Sierra-Lobo/fp-pib-hw/revB/doc/pib-revB-bom.xlsx

Item | Qty | Reference(s) | Value | DNP | Description | Manufacturer | Mfr. Part No | LibPart | Footprint
1 | 3 | C1, C15, C16 | 0.01uF |  | CAP CER 10000PF 50V X7R 0603 | TDK Corporation | CGA3E2X7R1H103K080AE | Device:C | Capacitor_SMD:C_0603_1608Metric
2 | 10 | C2, C3, C5, C8, C9, C10, C11, C12, C13, C14 | 0.1uF |  | CAP CER 0.1UF 50V X7R 0402 | TDK Corporation | CGA2B3X7R1H104K050BE | Device:C | Capacitor_SMD:C_0603_1608Metric
3 | 2 | C4, C7 | 1uF |  | CAP CER 1UF 25V X7R 0603 | TDK Corporation | CGA3E1X7R1E105K080AE | Device:C | Capacitor_SMD:C_0603_1608Metric
4 | 1 | C6 | 10uF |  | CAP CER 10UF 25V X7S 0805 | TDK Corporation | CGA4J1X7S1E106K125AE | Device:C | Capacitor_SMD:C_0805_2012Metric
5 | 1 | D1 | RED |  | LED RED CLEAR SMD R/A | Kingbright | APA2107LSECK/J3-PRV | Device:D | SierraLobo:APA2107x
6 | 1 | D2 | YELLOW |  | LED YELLOW CLEAR SMD R/A | Kingbright | APA2107SYCK | Device:D | SierraLobo:APA2107x
7 | 1 | D3 | ORANGE |  | APA2107SECK | Kingbright | APA2107SECK | Device:D | SierraLobo:APA2107x
8 | 1 | D4 | GREEN |  | APA2107CGCK | Kingbright | APA2107CGCK | Device:D | SierraLobo:APA2107x
9 | 1 | J1 | T1M-10-F-SV-L |  | CONN HEADER SMD 10POS 1MM | Samtec | T1M-10-F-SV-L | Connector_Generic:Conn_01x10 | payload-interface-board:SAMTEC_T1M-10-F-SV-L
10 | 1 | J2 | T1M-10-F-SV-L |  | CONN HEADER SMD 10POS 1MM | Samtec | T1M-10-F-SV-L | Connector_Generic:Conn_02x05_Odd_Even | payload-interface-board:SAMTEC_T1M-10-F-SV-L
11 | 1 | Q1 | MMDT3946 |  | TRANS NPN/PNP 40V 0.2A SOT363 | Diodes Incorporated | MMDT3946-7-F | Transistor_BJT:MMDT3946 | Package_TO_SOT_SMD:SOT-363_SC-70-6
12 | 4 | Q2, Q3, Q10, Q11 | MMDT2222A |  | TRANS 2NPN 40V 0.6A SOT363 | Diodes Incorporated | MMDT2222A-7-F | SierraLobo:MMDT2222 | Package_TO_SOT_SMD:SOT-363_SC-70-6
13 | 4 | Q4, Q5, Q7, Q8 | BSZ180 |  | MOSFET P-CH 30V 9A/39.6A TSDSON | Infineon Technologies | BSZ180P03NS3GATMA1 | SierraLobo:BSZ086 | SierraLobo:PG-TSDSON-8_3.3x3.3mm
14 | 2 | Q6, Q9 | MMBT4401 |  | TRANS NPN 40V 0.6A SC70-3 | onsemi | MMBT4401WT1G | Device:Q_NPN_BEC | Package_TO_SOT_SMD:SOT-323_SC-70
15 | 2 | Q14, Q15 | BSS138 |  | MOSFET 2NCH 50V 200MA SOT363 | Diodes Incorporated | BSS138DWQ-7 | mainboard:BSS138DWQ-7 | Package_TO_SOT_SMD:SOT-363_SC-70-6
16 | 2 | R1, R5 | 100k | DNP | RES 100K OHM 1% 1/10W 0603 | Stackpole Electronics Inc | RMCF0603FT100K | Device:R_US | Resistor_SMD:R_0603_1608Metric
17 | 8 | R2, R6, R33, R36, R37, R40, R47, R48 | 100k |  | RES 100K OHM 1% 1/10W 0603 | Stackpole Electronics Inc | RMCF0603FT100K | Device:R_US | Resistor_SMD:R_0603_1608Metric
18 | 2 | R3, R4 | 4.7k |  | RES 4.7K OHM 1% 1/10W 0603 | Stackpole Electronics Inc | RMCF0603FT4K70 | Device:R_US | Resistor_SMD:R_0603_1608Metric
19 | 2 | R7, R9 | 0 |  | RES 0 OHM JUMPER 1/10W 0603 | Stackpole Electronics Inc | RMCF0603ZT0R00 | Device:R_US | Resistor_SMD:R_0603_1608Metric
20 | 4 | R8, R10, R51, R52 | 0 | DNP | RES 0 OHM JUMPER 1/10W 0603 | Stackpole Electronics Inc | RMCF0603ZT0R00 | Device:R_US | Resistor_SMD:R_0603_1608Metric
21 | 9 | R11, R12, R15, R16, R22, R41, R42, R43, R44 | 10k |  | RES 10K OHM 1% 1/10W 0603 | Stackpole Electronics Inc | RMCF0603FT10K0 | Device:R_US | Resistor_SMD:R_0603_1608Metric
22 | 8 | R13, R14, R17, R18, R34, R35, R38, R39 | 1k |  | RES 1K OHM 1% 1/10W 0603 | Stackpole Electronics Inc | RMCF0603FG1K00 | Device:R_US | Resistor_SMD:R_0603_1608Metric
23 | 2 | R19, R21 | 220 |  | RES 220 OHM 1% 1/10W 0603 | Stackpole Electronics Inc | RMCF0603FT220R | Device:R_US | Resistor_SMD:R_0603_1608Metric
24 | 1 | R20 | 976k |  | RES 976K OHM 1% 1/10W 0603 | Stackpole Electronics Inc | RMCF0603FT976K | Device:R_US | Resistor_SMD:R_0603_1608Metric
25 | 1 | R23 | 105k |  | RES 105K OHM 1% 1/10W 0603 | Stackpole Electronics Inc | RMCF0603FT105K | Device:R_US | Resistor_SMD:R_0603_1608Metric
26 | 1 | R24 | 576k |  | RES 576K OHM 1% 1/10W 0603 | Stackpole Electronics Inc | RMCF0603FT576K | Device:R_US | Resistor_SMD:R_0603_1608Metric
27 | 4 | R25, R26, R27, R28 | 1.5k |  | RES 1.5K OHM 1% 1/16W 0402 | Stackpole Electronics Inc | RMCF0402FT1K50 | Device:R_US | Resistor_SMD:R_0402_1005Metric
28 | 4 | R29, R30, R31, R32 | 10k |  | RES 10K OHM 1% 1/16W 0402 | Stackpole Electronics Inc | RMCF0402FT10K0 | Device:R_US | Resistor_SMD:R_0402_1005Metric
29 | 2 | R45, R46 | 680 |  | RES 680 OHM 1% 1/10W 0603 | Stackpole Electronics Inc | RMCF0603FT680R | Device:R_US | Resistor_SMD:R_0603_1608Metric
30 | 2 | R49, R50 | 200k |  | RES 200K OHM 1% 1/10W 0603 | Stackpole Electronics Inc | RMCF0603FT200K | Device:R_US | Resistor_SMD:R_0603_1608Metric
31 | 4 | RN1, RN3, RN4, RN6 | 1k |  | RES ARRAY 4 RES 10K OHM 0804 | Panasonic | EXB-28V102JX | FP-Interface-Card:R_Network04_US | Resistor_SMD:R_Array_Convex_4x0402
32 | 2 | RN2, RN5 | 10k |  | RES ARRAY 4 RES 1K OHM 0804 | Panasonic | EXB-28V103JX | SierraLobo:R_Network04_US | Resistor_SMD:R_Array_Convex_4x0402
33 | 17 | TP2, TP3, TP4, TP5, TP6, TP9, TP10, TP11, TP12, TP13, TP14, TP16, TP17, TP18, TP19, TP20, TP22 | ${NET_NAME(1)} |  | PC TEST POINT MINIATURE WHITE | Keystone | 5002 | Connector:TestPoint_Small | TestPoint:TestPoint_Keystone_5000-5004_Miniature
34 | 3 | TP7, TP15, TP21 | ${NET_NAME(1)} |  | PC TEST POINT MINIATURE | Keystone | 5027 | Connector:TestPoint_Small | SierraLobo:Keystone_5027
35 | 1 | U1 | LTC4307 |  | IC ACCELERATOR I2C HOTSWAP 8MSOP | Analog Devices | LTC4307IMS8#TRPBF | mainboard_SLI:LTC4307 | Package_SO:MSOP-8_3x3mm_P0.65mm
36 | 1 | U2 | RockBlock_9603 |  |  | Ground Control | FP-RB-9603 | SierraLobo:RockBlock_9603 | SierraLobo:RockBlock_9603
37 | 2 | U3, U4 | SN74LVCH245APWR |  | IC TXRX NON-INVERT 3.6V 20TSSOP | Texas Instruments | SN74LVCH245APWR | FP-Interface-Card:SN74LVCH245APWR | Package_SO:TSSOP-20_4.4x6.5mm_P0.65mm
38 | 2 | U5, U7 | MCP9700AT-E/LT |  | SENSOR ANALOG -40C-125C SC70-5 | Microchip Technology | MCP9700AT-E/LT | Sensor_Temperature:MCP9700Ax-ELT | Package_TO_SOT_SMD:SOT-353_SC-70-5
39 | 1 | U6 | imu-stamp-revA |  | PCBA, IMU | Sierra Lobo | RD21-6005A | FP-Interface-Card:imu-stamp-revA | payload-interface-board:imu-stamp-revA-SMD
