Sierra-Lobo/fp-pib-hw/revA1/FP Interface Card.xlsx

Item | Qty | Reference(s) | Value | LibPart | Footprint | Datasheet
1 | 31 | C1, C2, C16, C17, C18, C29, C31, C32, C33, C38, C39, C40, C41, C43, C44, C49, C50, C53, C55, C56, C57, C60, C61, C62, C63, C64, C65, C66, C67, C68, C69 | 0.1uF | Device:C | Capacitor_SMD:C_0603_1608Metric | ~
2 | 3 | C3, C51, C58 | 4.7uF | Device:C | Capacitor_SMD:C_0805_2012Metric | ~
3 | 7 | C4, C5, C6, C7, C8, C11, C12 | 0.1uF | Device:C | Capacitor_SMD:C_0402_1005Metric | ~
4 | 1 | C9 | 1nF | Device:C | Capacitor_SMD:C_0402_1005Metric | ~
5 | 1 | C10 | 10uF | Device:C | Capacitor_SMD:C_0603_1608Metric | ~
6 | 1 | C13 | 47uF | Device:C | Capacitor_SMD:C_1206_3216Metric | GRT31CR61A476KE13L
7 | 4 | C14, C15, C45, C46 | 2.2uF | Device:C | Capacitor_SMD:C_0805_2012Metric | ~
8 | 6 | C19, C20, C47, C48, C70, C71 | 10nF | Device:C | Capacitor_SMD:C_0603_1608Metric | ~
9 | 2 | C21, C22 | 0.47uF | Device:C | Capacitor_SMD:C_0603_1608Metric | ~
10 | 8 | C23, C24, C27, C28, C52, C54, C59, C72 | 1uF | Device:C | Capacitor_SMD:C_0603_1608Metric | ~
11 | 5 | C25, C26, C30, C35, C36 | 10uF | Device:C | Capacitor_SMD:C_0805_2012Metric | ~
12 | 3 | C34, C37, C42 | 560pF | Device:C | Capacitor_SMD:C_0603_1608Metric | ~
13 | 1 | C73 | 0.01uF | Device:C | Capacitor_SMD:C_0603_1608Metric | ~
14 | 3 | D1, D6, D7 | TPSMF4L6.0A | Device:D_TVS | Diode_SMD:D_SOD-123F | TPSMF4L6.0A
15 | 1 | D2 | RED | Device:D | SLI-Backplane-Blank-Card-KiCad:APA2107x | APA2107LSECK/J3-PRV
16 | 1 | D3 | YELLOW | Device:D | SLI-Backplane-Blank-Card-KiCad:APA2107x | APA2107SYCK/J3-PRV
17 | 1 | D4 | GREEN | Device:D | SLI-Backplane-Blank-Card-KiCad:APA2107x | APA2107CGCK
18 | 1 | D5 | ORANGE | Device:D | SLI-Backplane-Blank-Card-KiCad:APA2107x | APA2107SECK/J4-PRV
19 | 1 | D8 | S1G | Device:D | Diode_SMD:D_SMA | S1G
20 | 4 | H1, H2, H3, H4 | SLI-Backplane-Blank-Card-KiCad:125mil_hole | Mechanical:MountingHole_Pad | SLI-Backplane-Blank-Card-KiCad:125mil_hole | ~
21 | 1 | J1 | T1M-10-F-SV-L | Connector_Generic:Conn_01x10 | payload-interface-board:SAMTEC_T1M-10-F-SV-L | T1M-10-F-SV-L
22 | 1 | J3 | ZX62-AB-5PA(31) | Connector:USB_B_Micro | SLI-Backplane-Blank-Card-KiCad:ZX62-AB-5PA(31) | ZX62-AB-5PA(31)
23 | 1 | J4 | T1M-6-F-SV-L | Connector_Generic:Conn_01x06 | payload-interface-board:SAMTEC_T1M-06-F-SV-L | T1M-6-F-SV-L
24 | 1 | J5 | T1M-10-F-SV-L | Connector_Generic:Conn_02x05_Odd_Even | payload-interface-board:SAMTEC_T1M-10-F-SV-L | T1M-10-F-SV-L
25 | 1 | P1 | Card Edge for HSEC8-160-01-S-DV-A-K-TR | SLI-Backplane-Blank-Card-KiCad:Conn_02x60_Top_Bottom | SLI-Backplane-Blank-Card-KiCad:HSEC8-160-CARD-EDGE
26 | 4 | Q1, Q2, Q3, Q4 | BC847BM3T5G | Device:Q_NPN_BEC | Package_TO_SOT_SMD:SOT-723 | BC847BM3T5G
27 | 4 | Q5, Q7, Q13, Q15 | BSS138DWQ-7 | mainboard:BSS138DWQ-7 | Package_TO_SOT_SMD:SOT-363_SC-70-6 | BSS138DWQ-7
28 | 4 | Q6, Q8, Q14, Q16 | MMDT5551-7-F | mainboard-rescue:MBT2222ADW1T1-Transistor_BJT-mainboard-rescue | Package_TO_SOT_SMD:SOT-363_SC-70-6 | MMDT5551-7-F
29 | 6 | Q9, Q10, Q11, Q12, Q24, Q26 | BSS138 | Device:Q_NMOS_GSD | Package_TO_SOT_SMD:SOT-23 | BSS138
30 | 4 | Q17, Q18, Q20, Q22 | MMBT4401-7-F | Device:Q_NPN_BEC | Package_TO_SOT_SMD:SOT-23 | MMBT4401-7-F
31 | 3 | Q19, Q21, Q23 | IRF7404TRPBF | SLI-Backplane-Blank-Card-KiCad:IRF7404TRPBF | Package_SO:SO-8_3.9x4.9mm_P1.27mm | IRF7404TRPBF
32 | 13 | R1, R2, R3, R30, R31, R41, R43, R59, R60, R61, R62, R63, R64 | 100 | Device:R_US | Resistor_SMD:R_0603_1608Metric | ~
33 | 8 | R4, R7, R8, R9, R11, R12, R14, R15 | 1.5k | Device:R_US | Resistor_SMD:R_0402_1005Metric | ~
34 | 1 | R5 | 1Meg | Device:R_US | Resistor_SMD:R_0402_1005Metric | ~
35 | 3 | R6, R10, R13 | 10k | Device:R_US | Resistor_SMD:R_0402_1005Metric | ~
36 | 24 | R16, R17, R18, R20, R22, R25, R35, R39, R40, R42, R44, R47, R52, R77, R82, R90, R93, R94, R99, R103, R104, R105, R111, R112 | 100k | Device:R_US | Resistor_SMD:R_0603_1608Metric | ~
37 | 28 | R19, R21, R23, R24, R49, R50, R54, R55, R65, R67, R68, R70, R71, R73, R74, R76, R79, R80, R84, R85, R89, R91, R100, R106, R108, R110, R114, R116 | 10k | Device:R_US | Resistor_SMD:R_0603_1608Metric | ~
38 | 6 | R26, R27, R28, R29, R45, R46 | 51 | Device:R_US | Resistor_SMD:R_0603_1608Metric | ~
39 | 2 | R32, R33 | 200mR | Device:R_US | Resistor_SMD:R_0805_2012Metric | RL1220S-R20-F
40 | 1 | R34 | 91mR | Device:R_US | Resistor_SMD:R_0805_2012Metric | UCR10EVHFSR091
41 | 3 | R36, R37, R38 | 33 | Device:R_US | Resistor_SMD:R_0603_1608Metric | ~
42 | 4 | R48, R53, R78, R83 | 680 | Device:R_US | Resistor_SMD:R_0603_1608Metric | ~
43 | 4 | R51, R56, R81, R86 | 200K | Device:R_US | Resistor_SMD:R_0603_1608Metric | ~
44 | 8 | R57, R58, R87, R88, R95, R96, R97, R98 | 0 | Device:R_US | Resistor_SMD:R_0603_1608Metric | ~
45 | 6 | R66, R69, R72, R75, R109, R115 | DNP | Device:R_US | Resistor_SMD:R_0603_1608Metric | ~
46 | 3 | R92, R101, R107 | 3.3k | Device:R_US | Resistor_SMD:R_0603_1608Metric | ~
47 | 1 | R102 | 100k | Device:R_US |  | ~
48 | 2 | R113, R117 | 4.7k | Device:R_US | Resistor_SMD:R_0603_1608Metric | ~
49 | 3 | RN1, RN2, RN3 | MAX5490GC01000+T | FP-Interface-Card:MAX5490GC01000+T | Package_TO_SOT_SMD:SOT-23 | MAX5490GC01000+T
50 | 1 | SW1 | SW_Push_SPST | Switch:SW_Push | SLI-Backplane-Blank-Card-KiCad:EVQP7C01P | EVQP7C01P
51 | 37 | TP1, TP2, TP3, TP4, TP5, TP6, TP7, TP8, TP9, TP10, TP11, TP12, TP13, TP14, TP15, TP16, TP17, TP18, TP19, TP20, TP21, TP22, TP23, TP24, TP25, TP26, TP27, TP28, TP29, TP30, TP31, TP32, TP33, TP34, TP35, TP38, TP39 | TestPoint | Connector:TestPoint | TestPoint:TestPoint_Pad_D1.0mm | ~
52 | 3 | U1, U16, U19 | DRV8838DSGT | magnetotorquer-test-board:DRV8838DSGT | Package_SON:WSON-8-1EP_2x2mm_P0.5mm_EP0.9x1.6mm | DRV8838DSGT
53 | 1 | U2 | AP2161W | Power_Management:AP2161W | Package_TO_SOT_SMD:SOT-23-5 | AP2161W
54 | 2 | U3, U4 | IAM-20380 | mainboard_SLI:IAM-20380 | payload-interface-board:IAM-20380 | IAM-20380
55 | 1 | U5 | PCA9543APW,118 | mainboard_SLI:PCA9543APW,118 | Package_SO:TSSOP-14_4.4x5mm_P0.65mm | PCA9543APW,118
56 | 2 | U6, U7 | MMC5983MA | mainboard_SLI:MMC5983MA | payload-interface-board:MMC5983MA | MMC5983MA
57 | 2 | U8, U9 | MXC6655XA | mainboard_SLI:MXC6655XA | payload-interface-board:MXC6655XA | MXC6655XA
58 | 1 | U10 | MAX7311AAG+ | FP-Interface-Card:MAX7311AAG+ | Package_SO:SSOP-24_5.3x8.2mm_P0.65mm | MAX7311AAG+
59 | 1 | U11 | MCP47FVB24-E/MQ | FP-Interface-Card:MCP47FVB24-E{slash}MQ | payload-interface-board:MCP47FVB24EMQ | MCP47FVB24-E/MQ
60 | 2 | U12, U15 | ALM2402QPWPRQ1 | magnetotorquer-test-board:ALM2402QPWPRQ1 | Package_SO:HTSSOP-14-1EP_4.4x5mm_P0.65mm_EP3.4x5mm_Mask3x3.1mm | ALM2402QPWPRQ1
61 | 4 | U13, U21, U22, U23 | OPA340MDBVTEP | Amplifier_Operational:OPA340NA | Package_TO_SOT_SMD:SOT-23-5 | OPA340MDBVTEP
62 | 1 | U14 | AD7091R-5BCPZ-RL7 | FP-Interface-Card:AD7091R-5BCPZ-RL7 | Package_DFN_QFN:QFN-20-1EP_4x4mm_P0.5mm_EP2.5x2.5mm | AD7091R-5BCPZ-RL7
63 | 3 | U17, U18, U20 | INA240A3EDRQ1 | FP-Interface-Card:INA240AxxD | Package_SO:SOIC-8_3.9x4.9mm_P1.27mm | INA240A3EDRQ1
64 | 1 | U24 | RockBlock_9603 | FP-Interface-Card:RockBlock_9603 | payload-interface-board:RockBlock_9603 | RockBlock_9603
65 | 1 | U25 | Pico | RPi_Pico:Pico | RPi_Pico:RPi_Pico_SMD_TH | Pico
66 | 1 | U26 | LTC4307 | mainboard_SLI:LTC4307 | Package_SO:MSOP-8_3x3mm_P0.65mm | LTC4307
67 | 2 | Z1, Z2 | CG0402MLU-05G | Device:Varistor | Capacitor_SMD:C_0402_1005Metric | CG0402MLU-05G
