Sierra-Lobo/fp-pib-hw/FP Interface Card.step

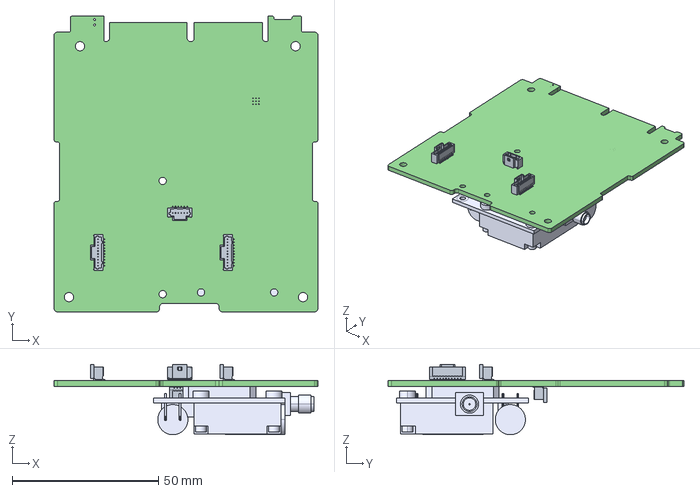
[picture p1: CAD file, 2022-05-12]
FP Interface Card.step
90.2 x 101.1 x 24.1 mm
FP Interface Card PCB
