Sierra-Lobo/fp-pib-hw/revB/doc/pib-revB-sch.pdf

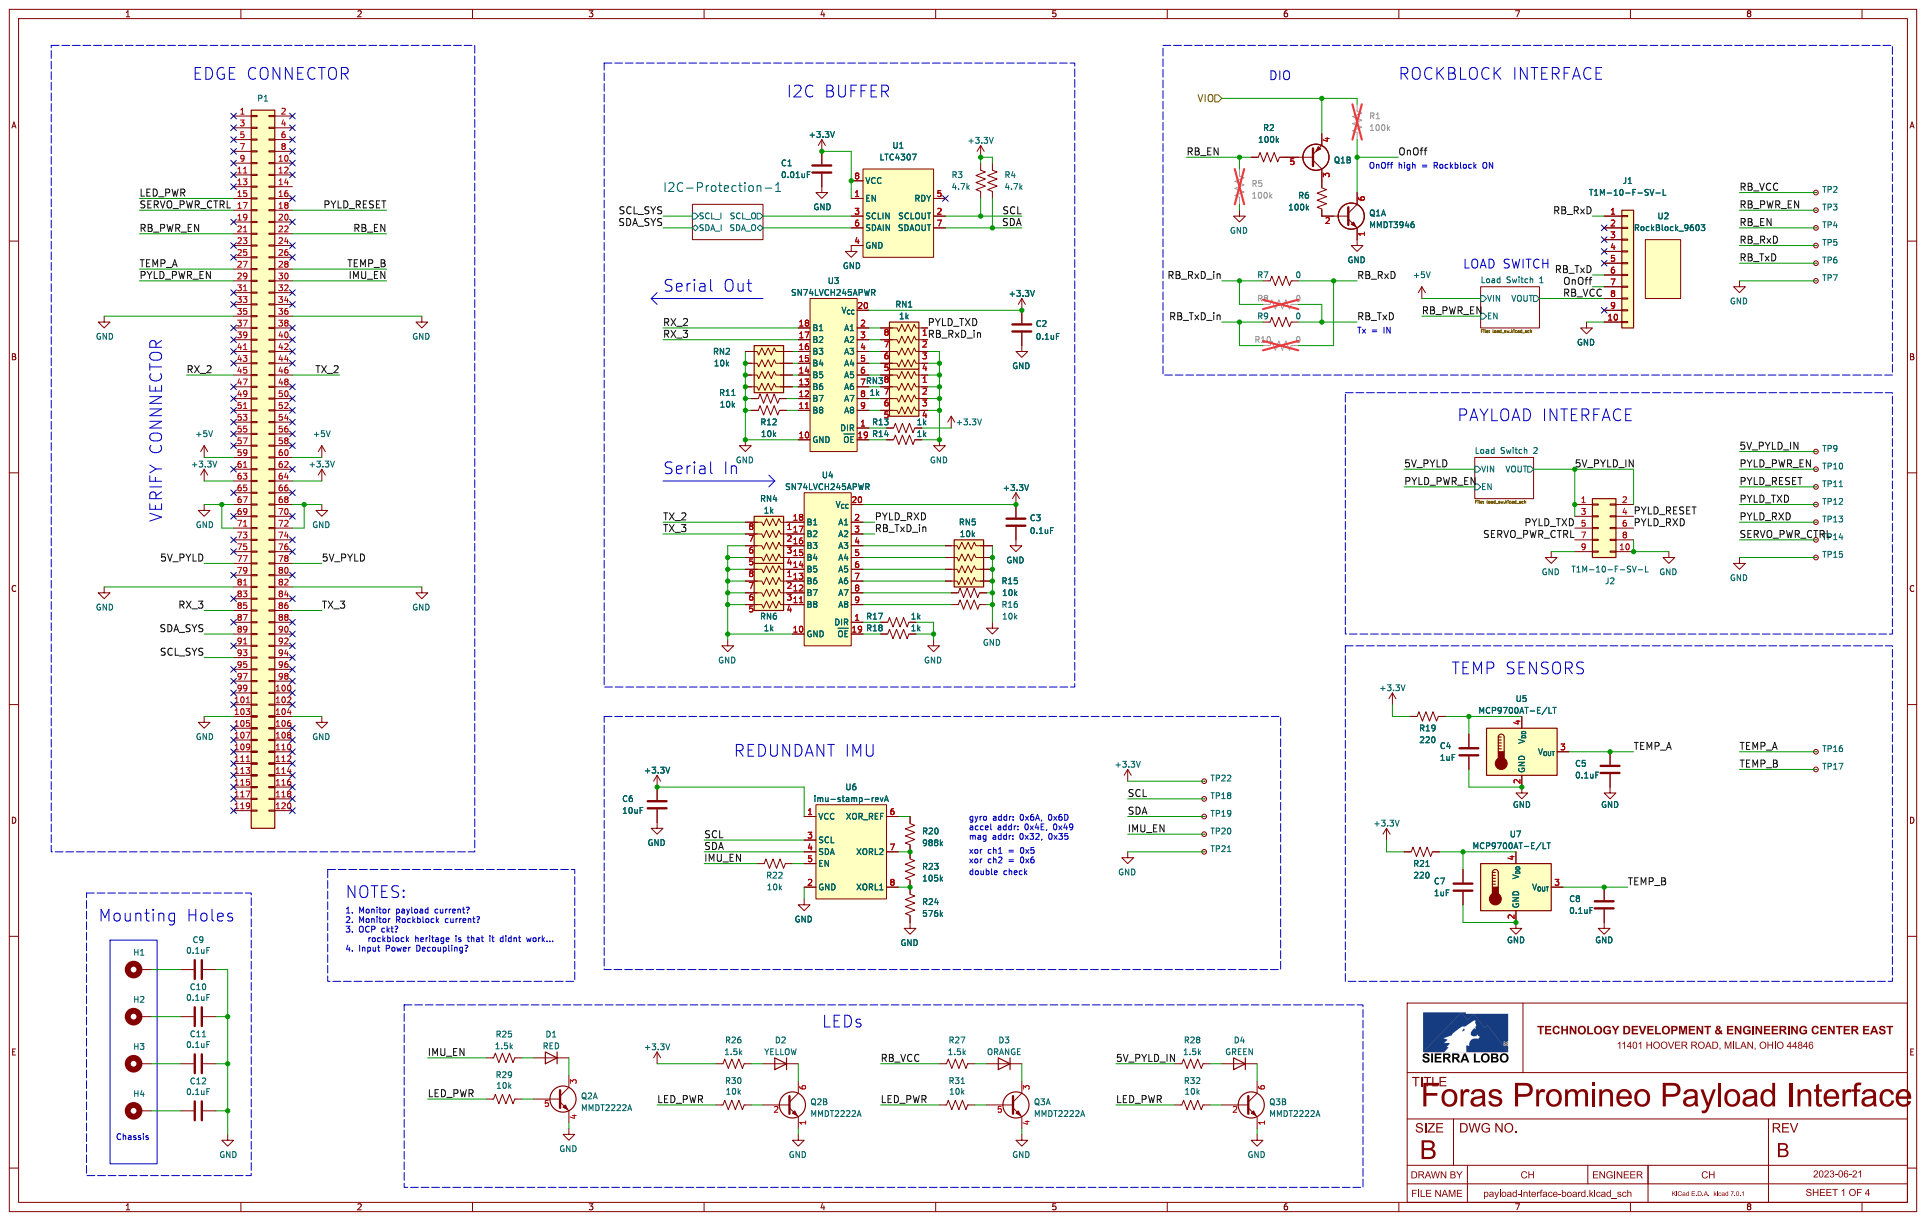
[picture p2: page 1]

Tx = IN ROCKBLOCK INTERFACE

TECHNOLOGY DEVELOPMENT & ENGINEERING CENTER EAST

11401 HOOVER ROAD, MILAN, OHIO 44846 TITLE
SHEET 1 OF 4 Foras Promineo Payload Interface

payload-interface-board.kicad_sch

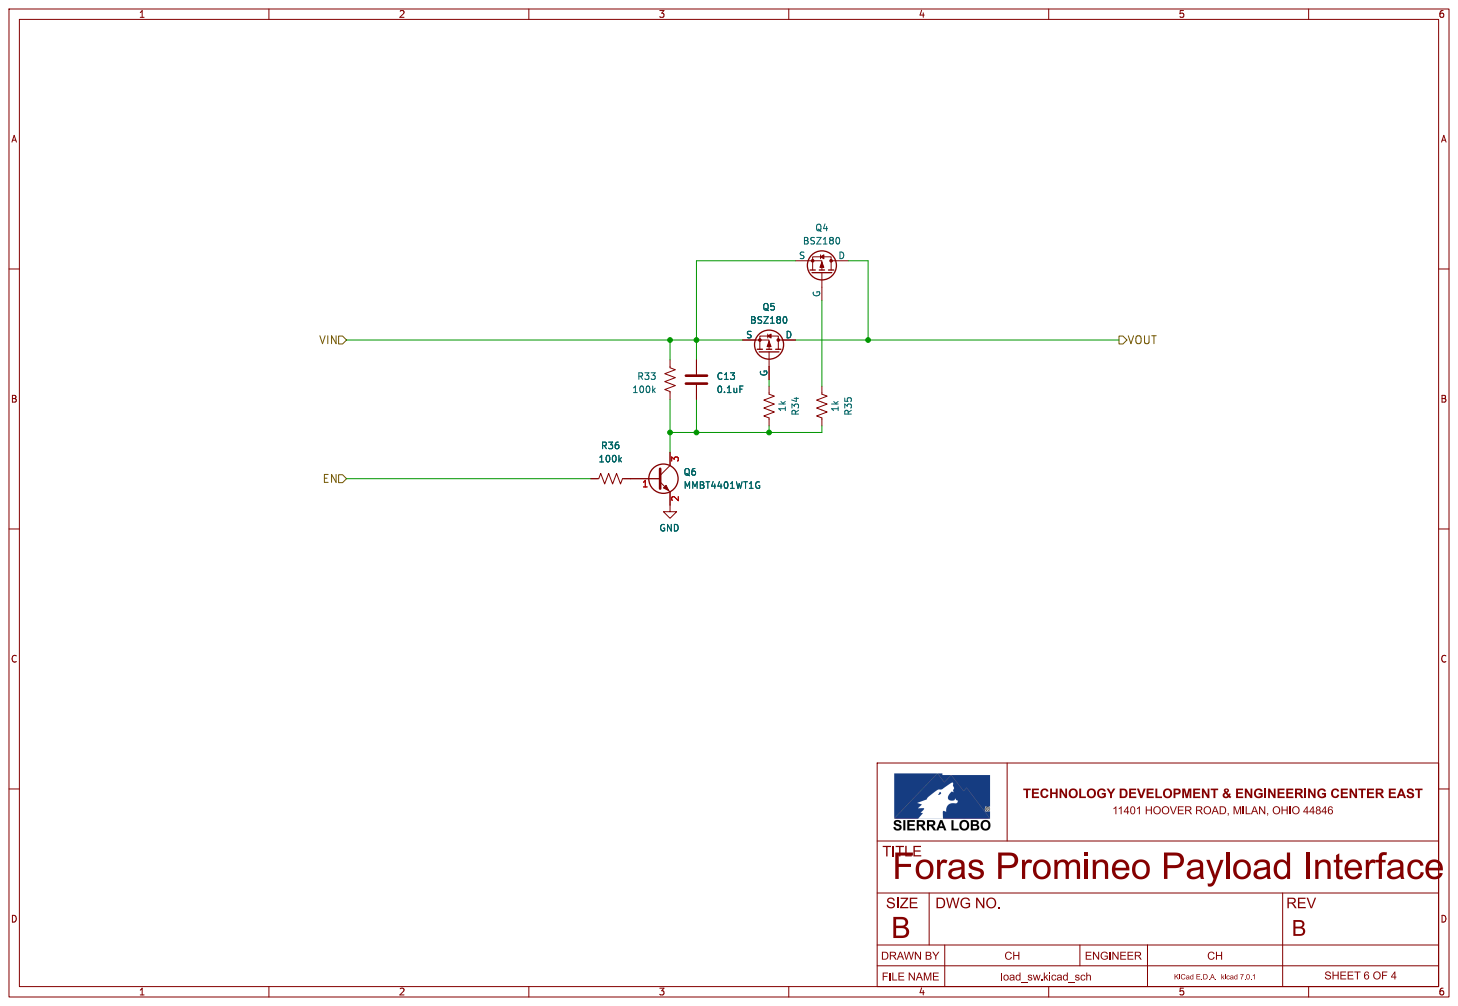
[picture p3: page 2]

TECHNOLOGY DEVELOPMENT & ENGINEERING CENTER EAST

11401 HOOVER ROAD, MILAN, OHIO 44846 TITLE
SHEET 6 OF 4 Foras Promineo Payload Interface

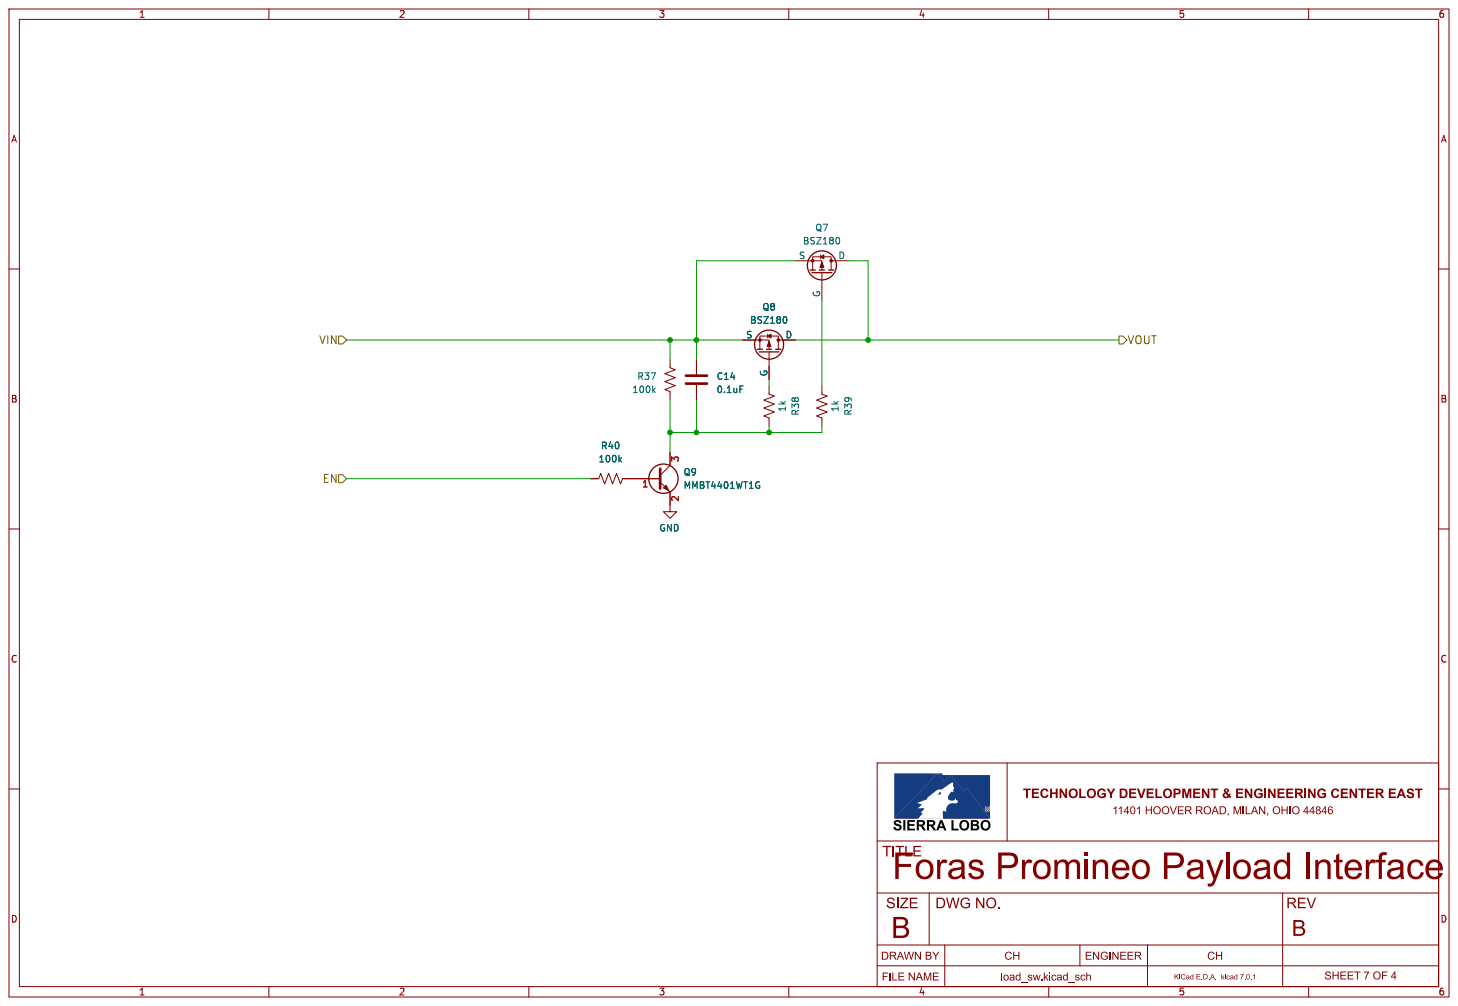
[picture p4: page 3]

TECHNOLOGY DEVELOPMENT & ENGINEERING CENTER EAST

11401 HOOVER ROAD, MILAN, OHIO 44846 TITLE
SHEET 7 OF 4 Foras Promineo Payload Interface

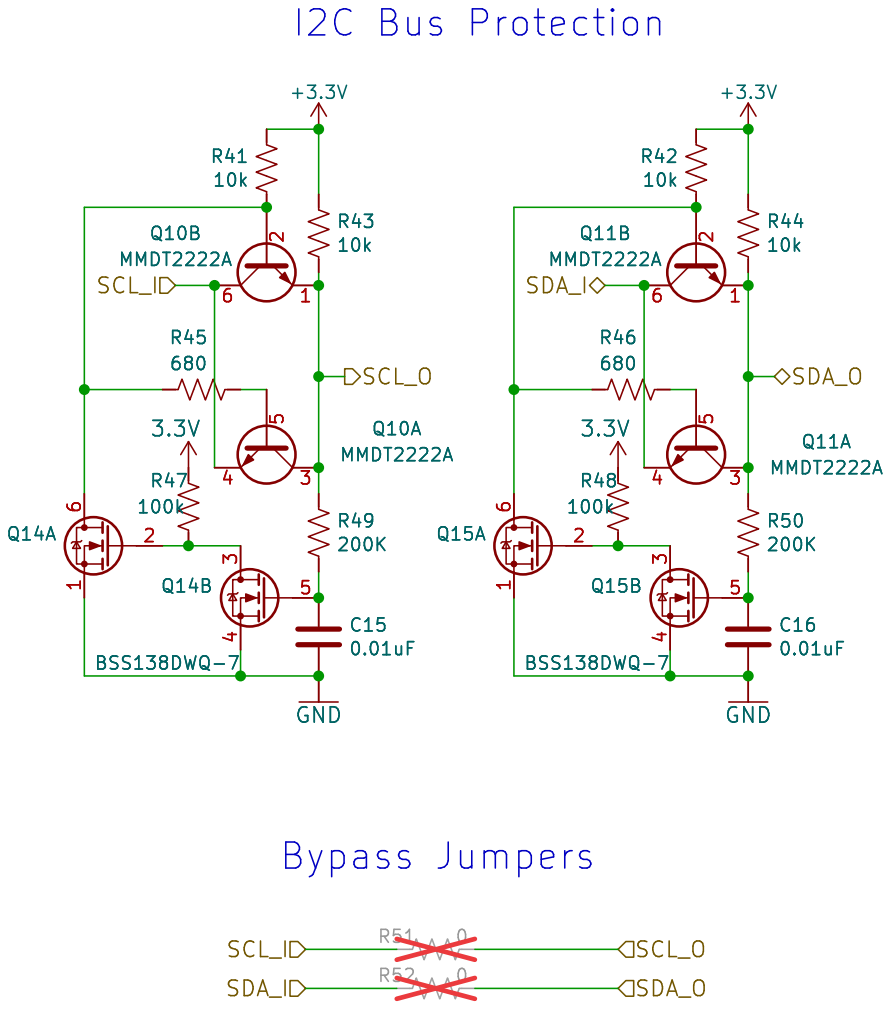
[picture p5: page 4]

TECHNOLOGY DEVELOPMENT & ENGINEERING CENTER EAST

11401 HOOVER ROAD, MILAN, OHIO 44846 TITLE
SHEET 11 OF 4 Foras Promineo Payload Interface
