Sierra-Lobo/fp-pib-hw/revA1/pdf/FP Interface Card.pdf

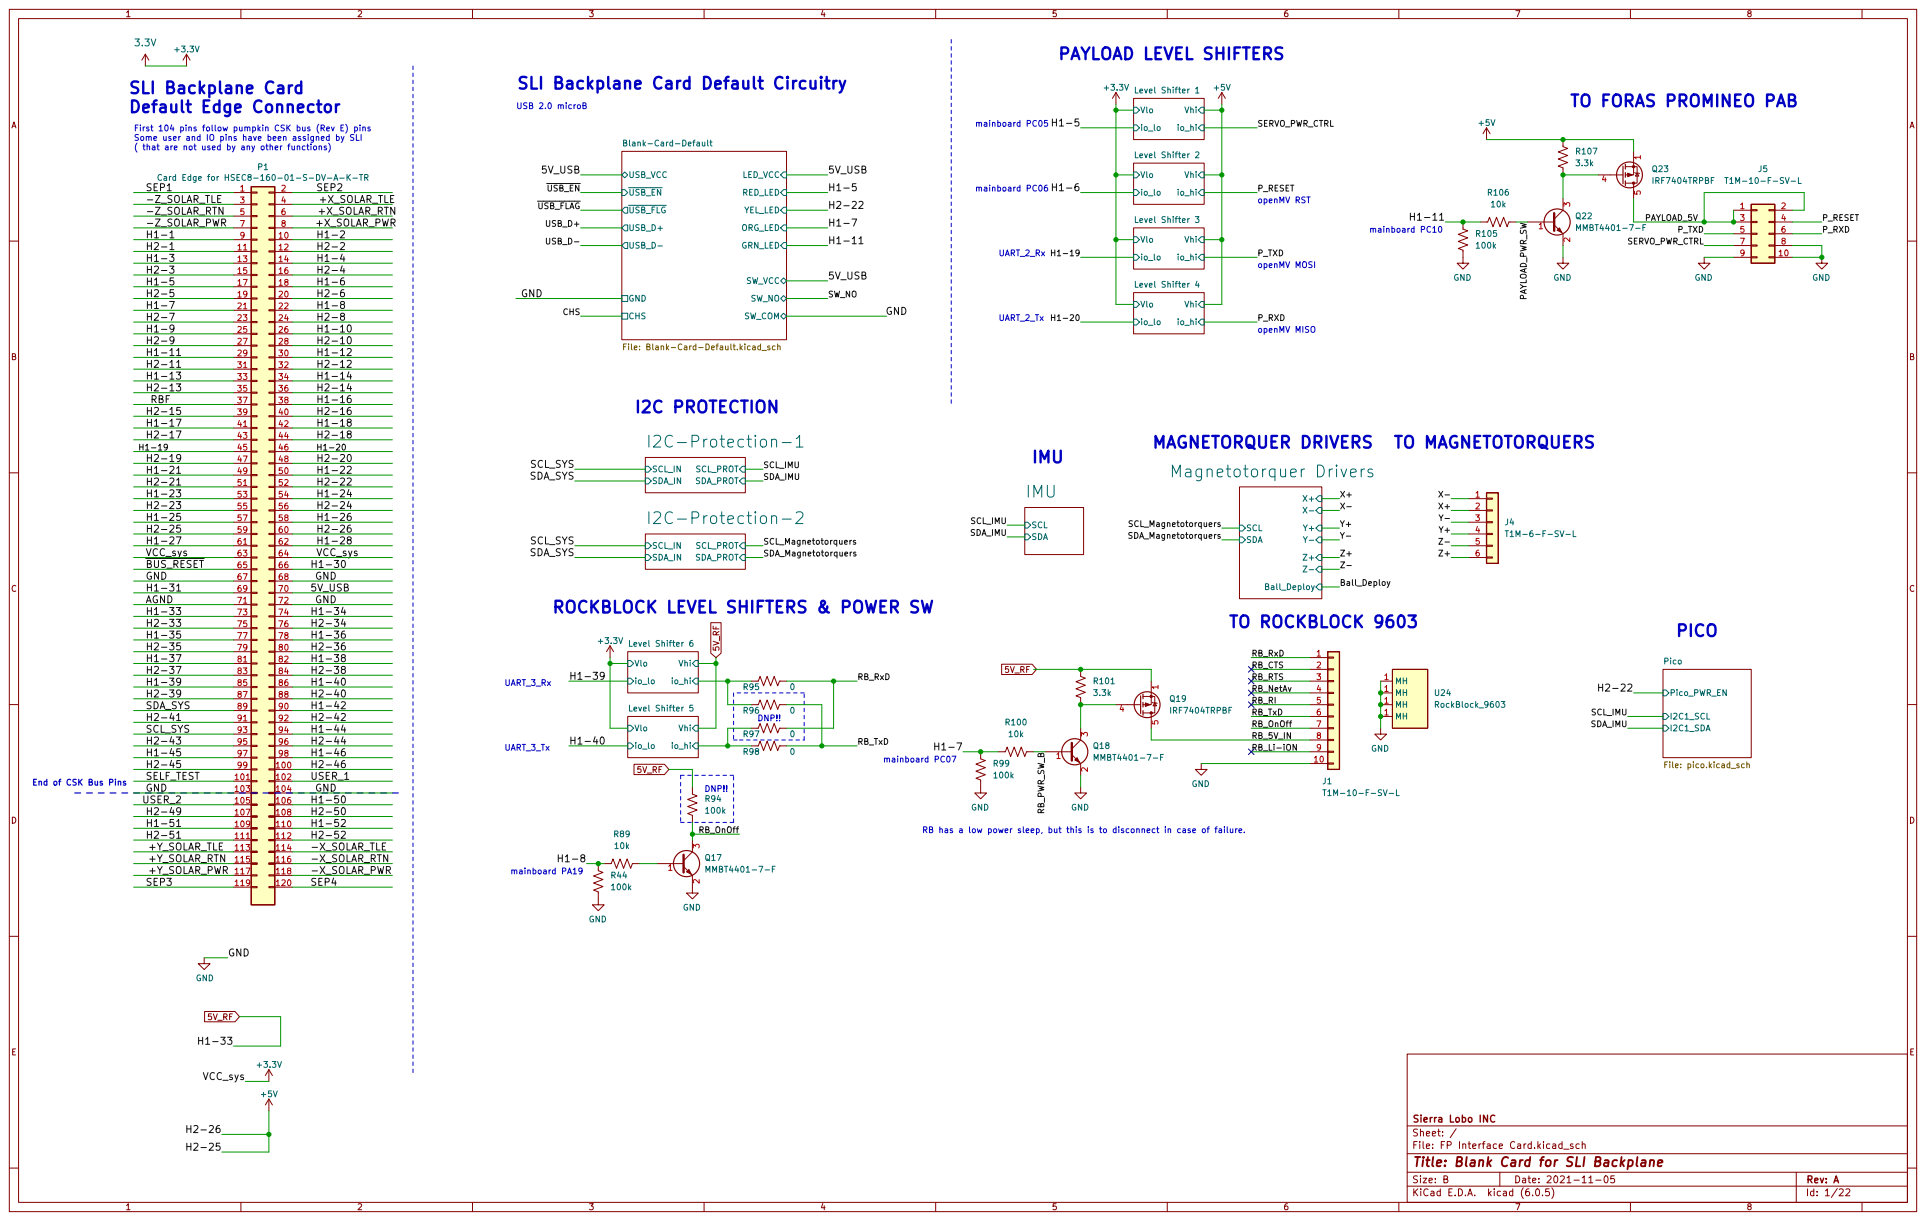
[picture p6: page 1]

Blank-Card-Default File: Blank-Card-Default.kicad_sch SDA_PROT SCL_IN

openMV RST mainboard PC05 mainboard PC06 SLI Backplane Card
Default Edge Connector

UART_2_Tx First 104 pins follow pumpkin CSK bus (Rev E) pins
Some user and IO pins have been assigned by SLI
( that are not used by any other functions)
SEP1 H2-3
-Z_SOLAR_TLE
-Z_SOLAR_RTN
-Z_SOLAR_PWR

P1 Card Edge for HSEC8-160-01-S-DV-A-K-TR

4 +X_SOLAR_TLE
+X_SOLAR_RTN 6

Pico File: pico.kicad_sch SCL SDA

ROCKBLOCK LEVEL SHIFTERS & POWER SW

-X_SOLAR_TLE
-X_SOLAR_RTN

File: FP Interface Card.kicad_sch Sheet: / Sierra Lobo INC

Id: 1/22 Title: Blank Card for SLI Backplane

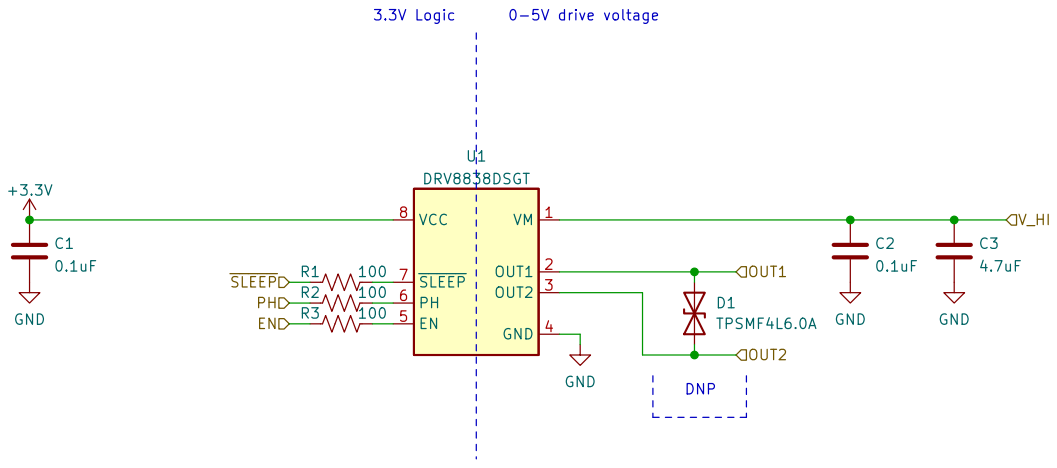
[picture p7: page 2]

Sheet: /Magnetotorquer Drivers/Full Bridge 2/
File: Full_Bridge.kicad_sch
Id: 2/22 Title:

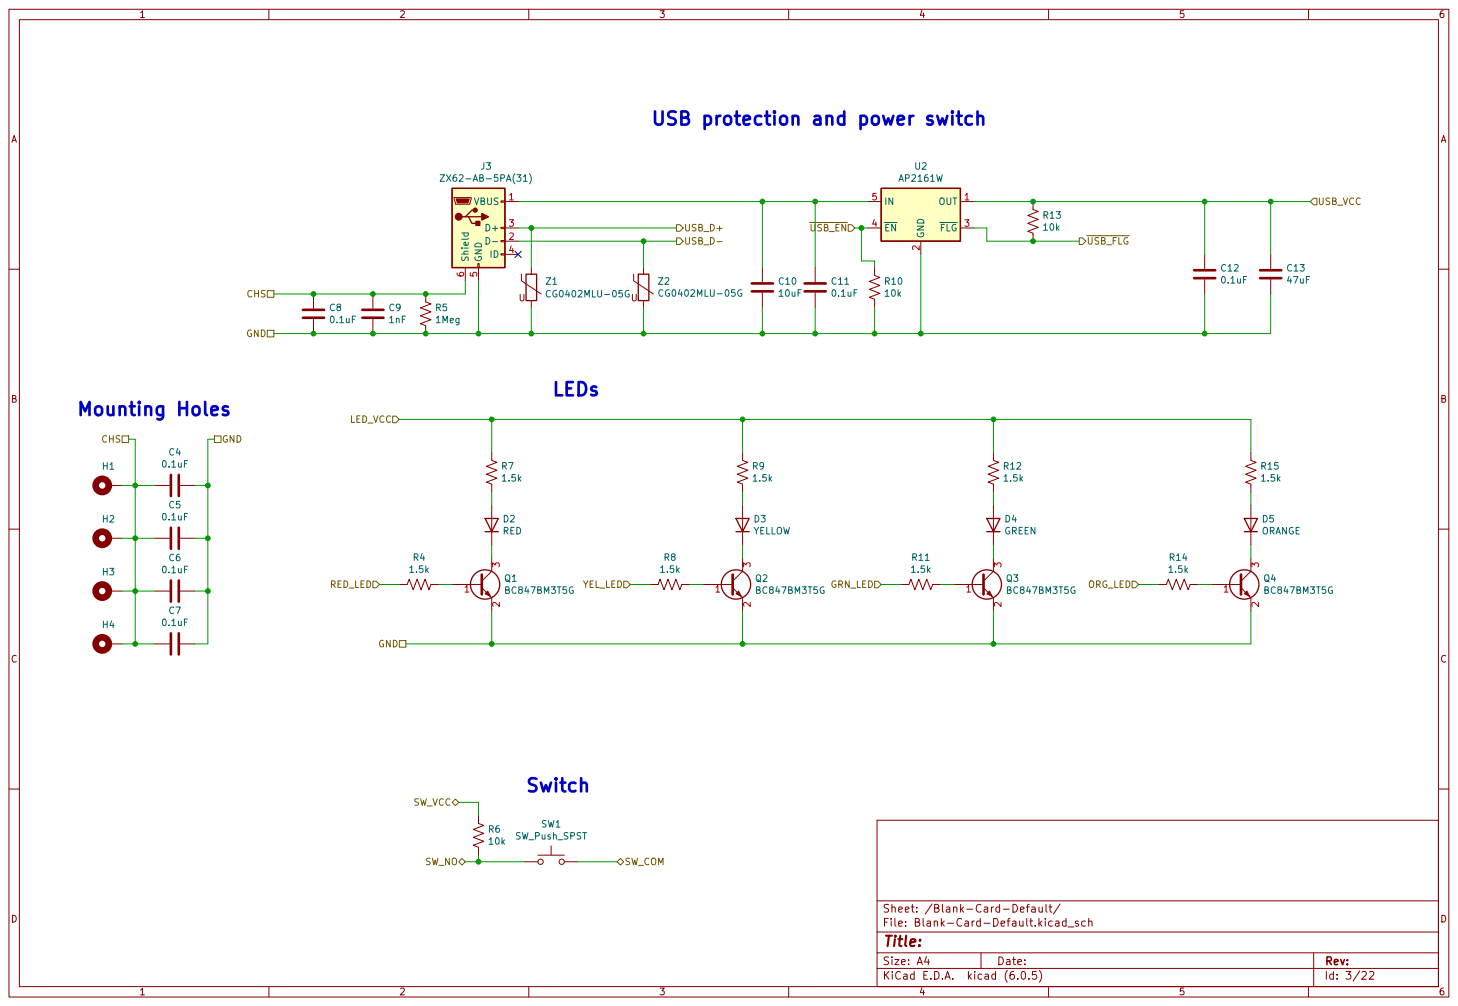
[picture p8: page 3]

CHS do we even need power thru usb?
USB_D+ SW_NO

USB protection and power switch
~{USB_EN} GRN_LED

File: Blank-Card-Default.kicad_sch Sheet: /Blank-Card-Default/ 1

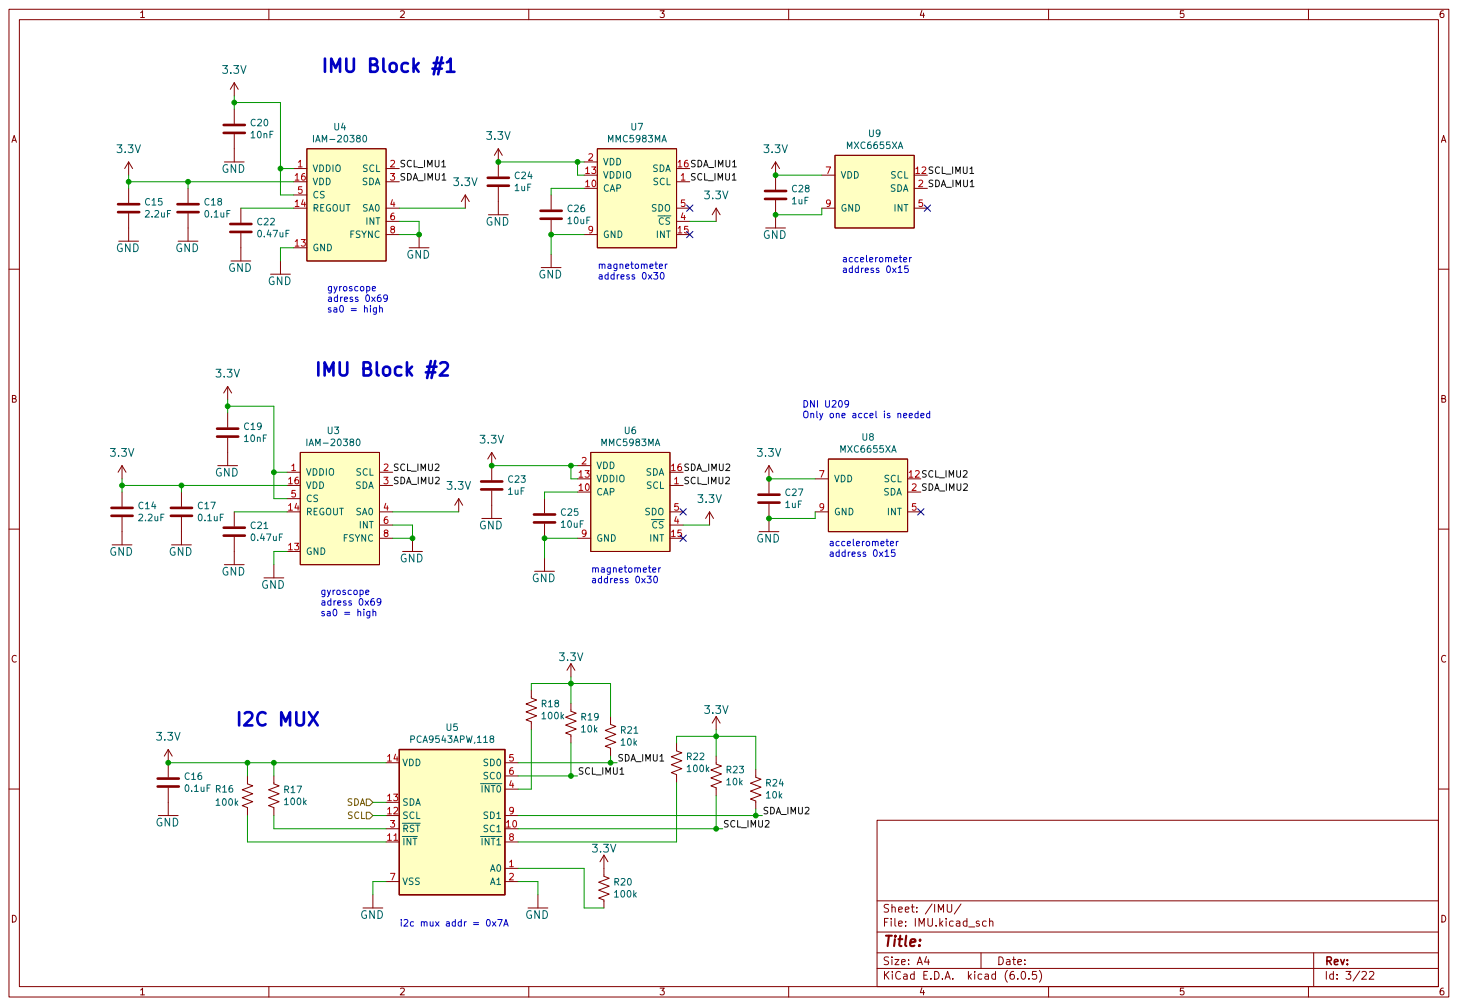
[picture p9: page 4]

File: IMU.kicad_sch Sheet: /IMU/

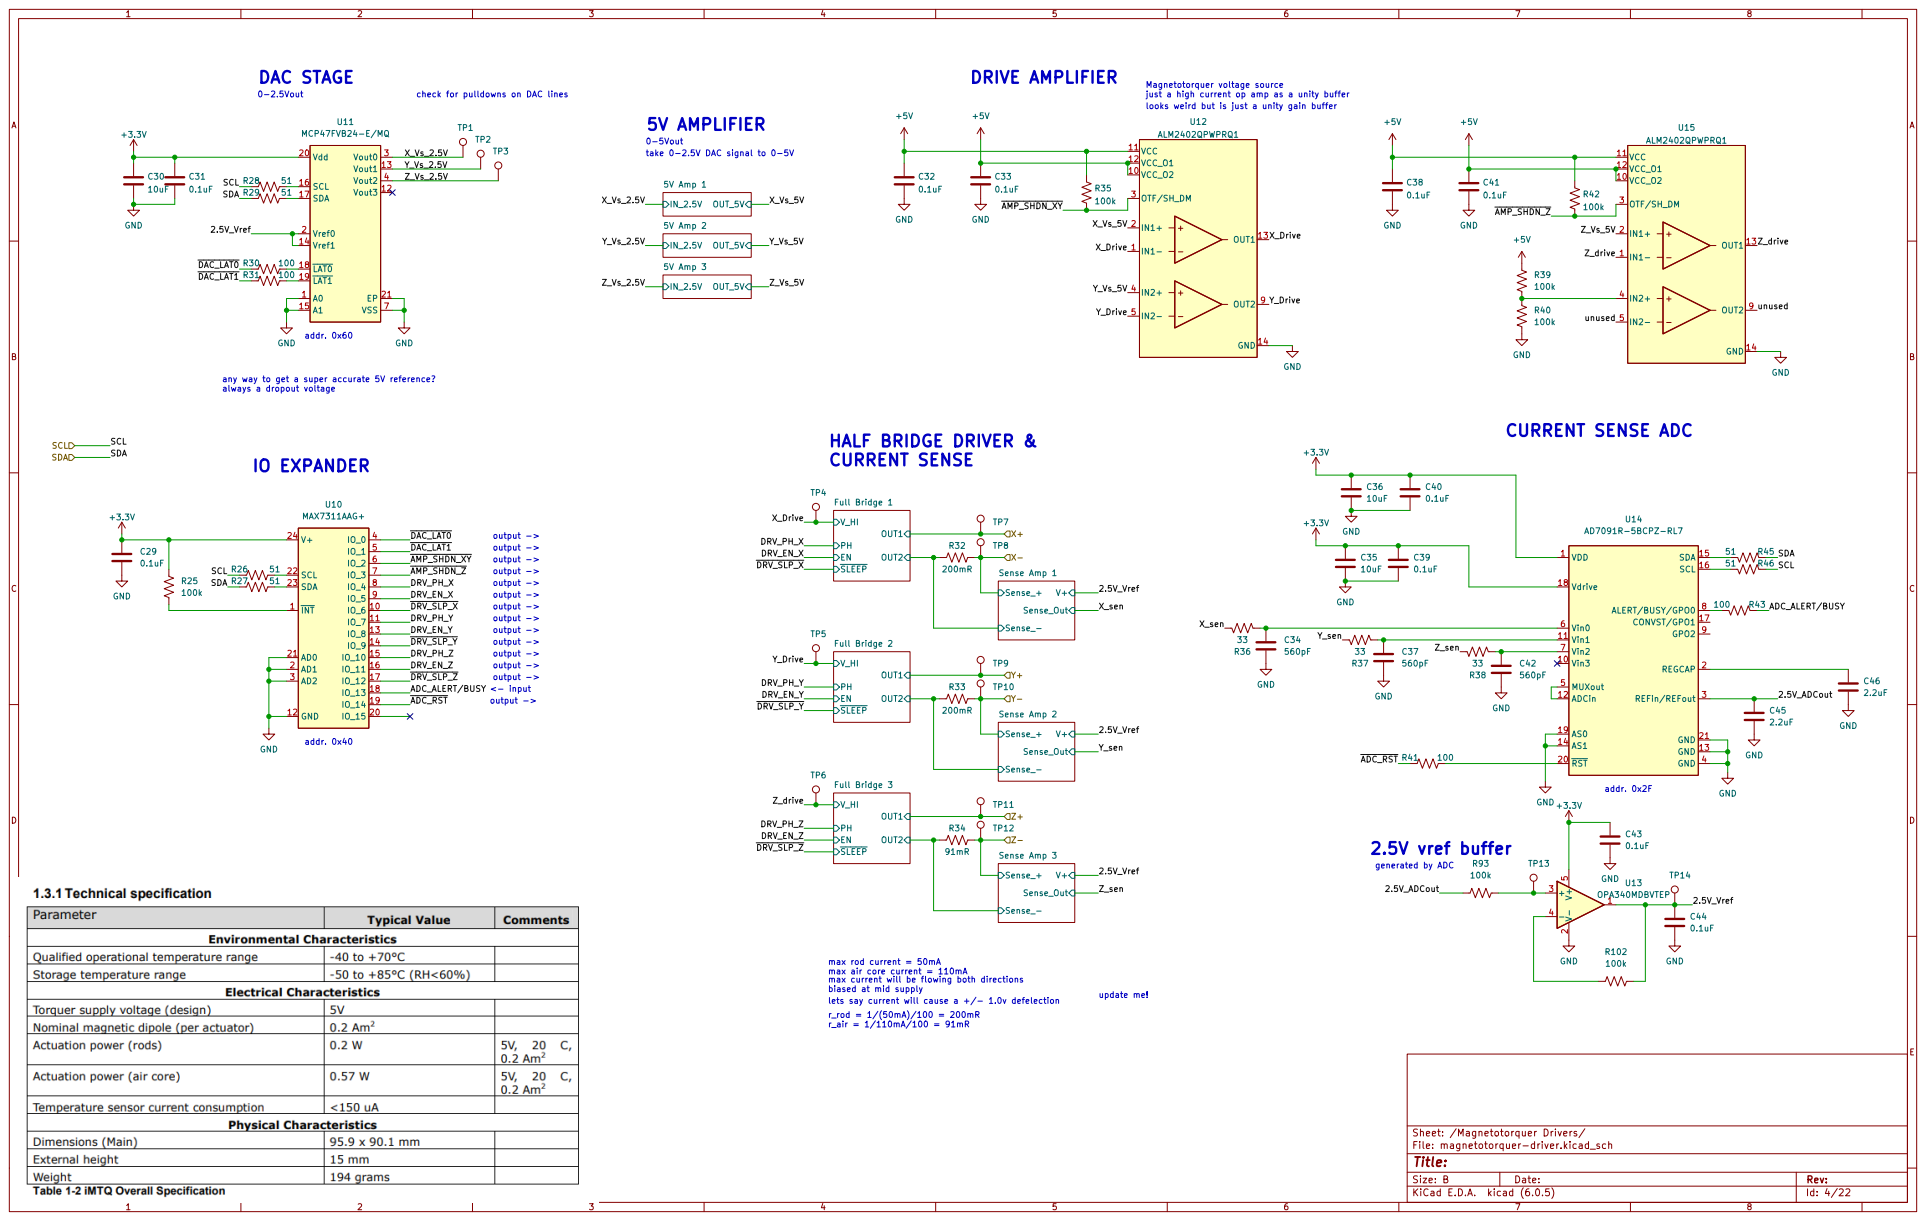
[picture p10: page 5]

Magnetotorquer voltage source
just a high current op amp as a unity buffer
looks weird but is just a unity gain buffer
0.1uF GND

check for pulldowns on DAC lines

take 0-2.5V DAC signal to 0-5V

any way to get a super accurate 5V reference?
always a dropout voltage

lets say current will cause a +/- 1.0v defelection max rod current = 50mA max air core current = 110mA max current will be flowing both directions

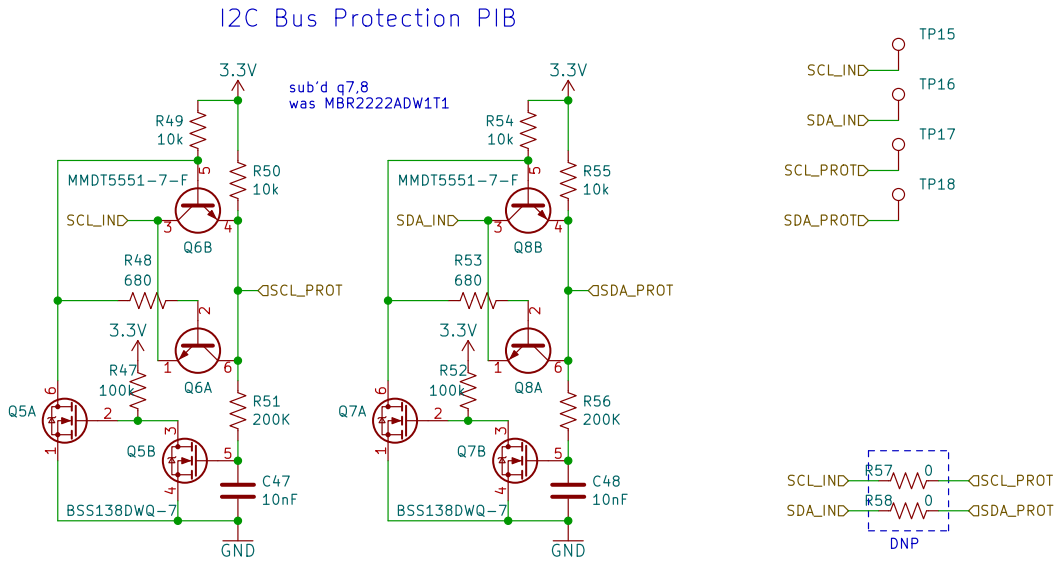
[picture p11: page 6]

File: I2C-Protection.kicad_sch Sheet: /I2C-Protection-2/
Id: 5/22 Title:

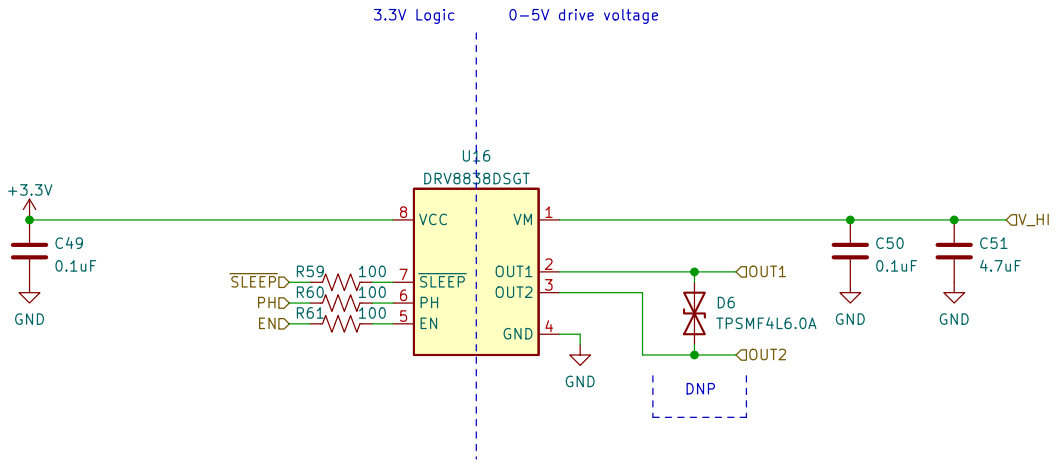
[picture p12: page 7]

Sheet: /Magnetotorquer Drivers/Full Bridge 1/
File: Full_Bridge.kicad_sch
Id: 6/22 Title:

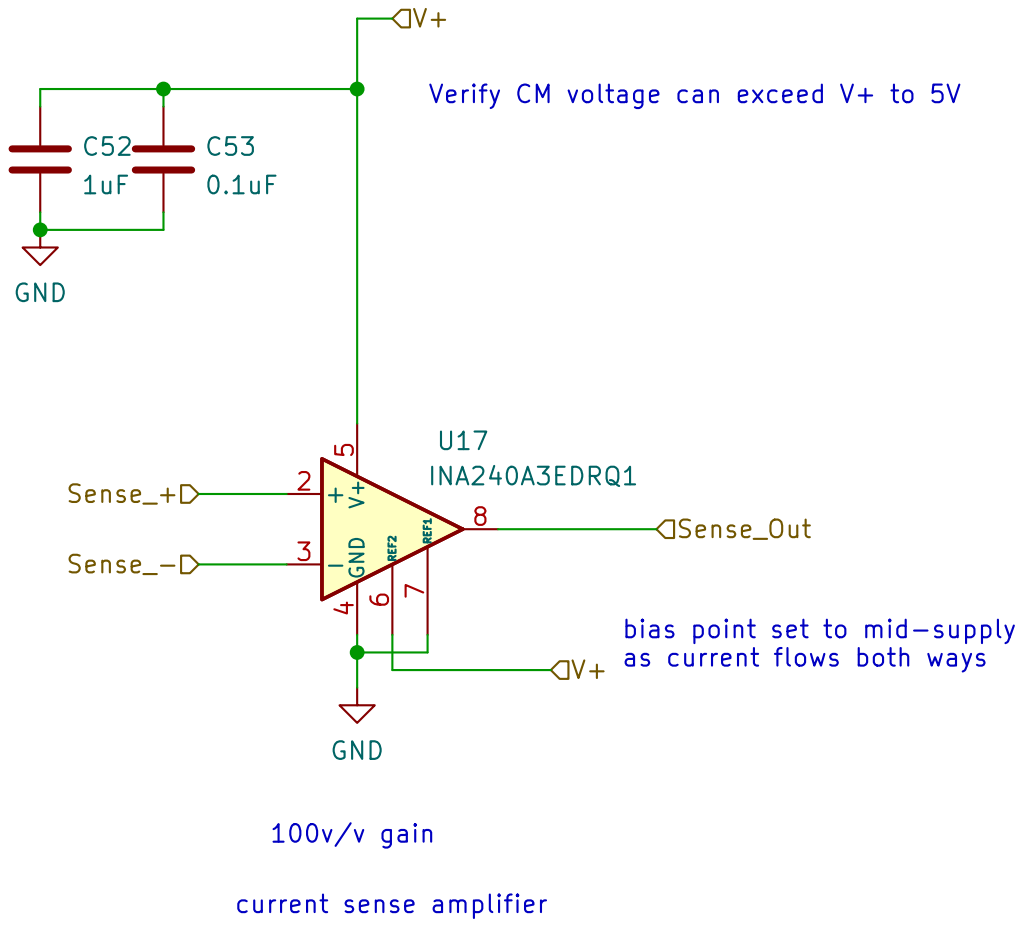
[picture p13: page 8]

bias point set to mid-supply
as current flows both ways

Sheet: /Magnetotorquer Drivers/Sense Amp 1/
File: Sense_Amp.kicad_sch
Id: 7/22 Title:

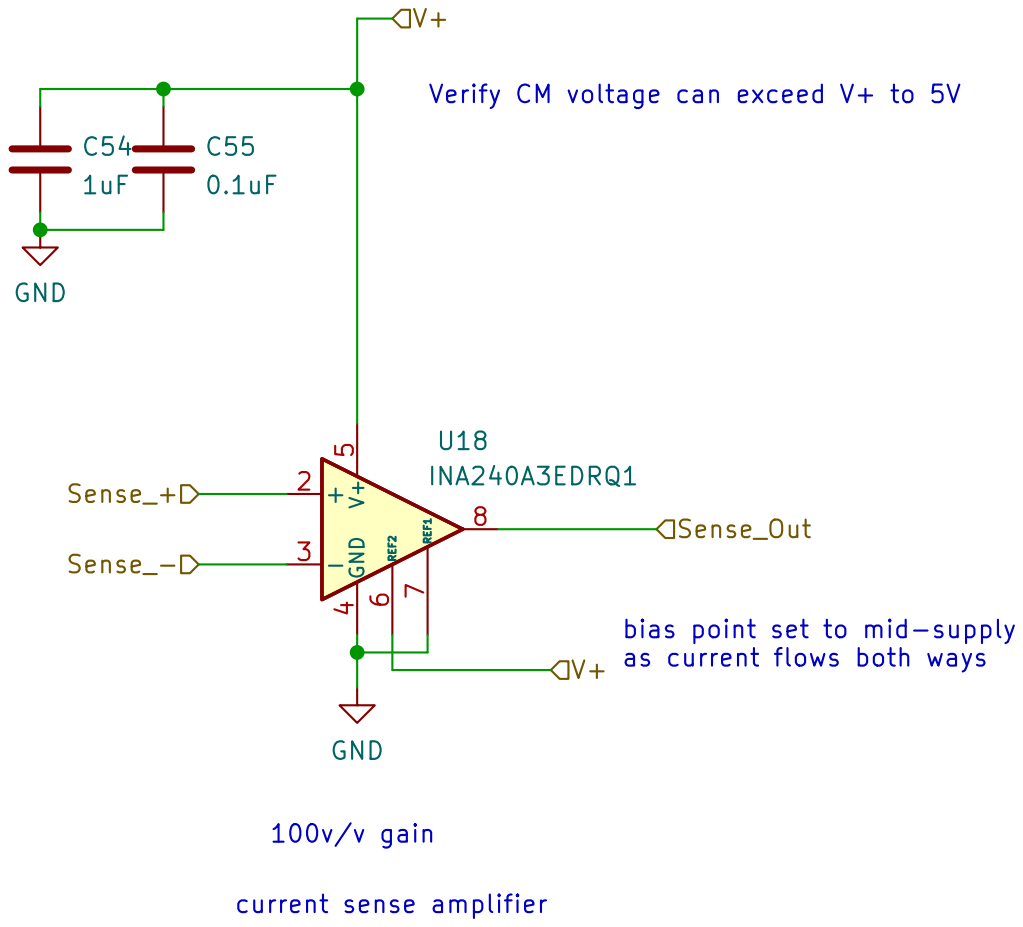
[picture p14: page 9]

bias point set to mid-supply
as current flows both ways

Sheet: /Magnetotorquer Drivers/Sense Amp 2/
File: Sense_Amp.kicad_sch
Id: 8/22 Title:

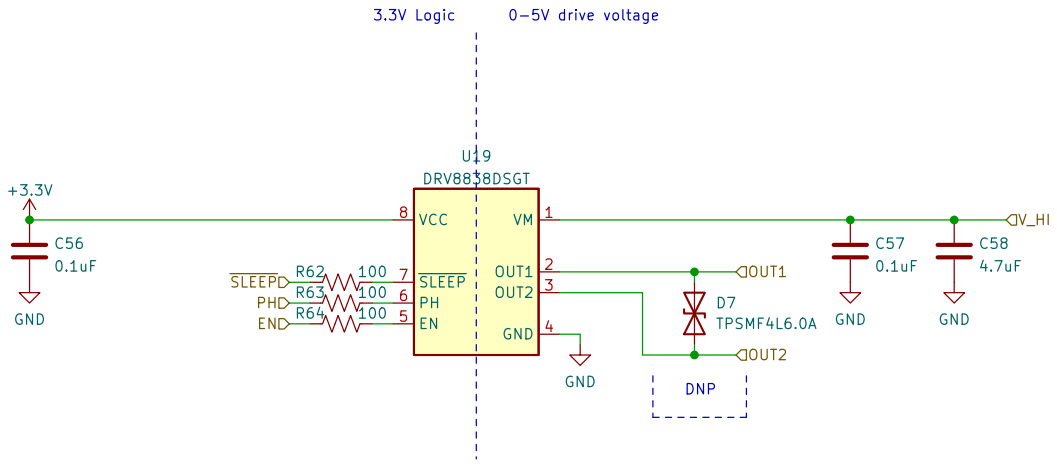
[picture p15: page 10]

Sheet: /Magnetotorquer Drivers/Full Bridge 3/
File: Full_Bridge.kicad_sch
Id: 9/22 Title:

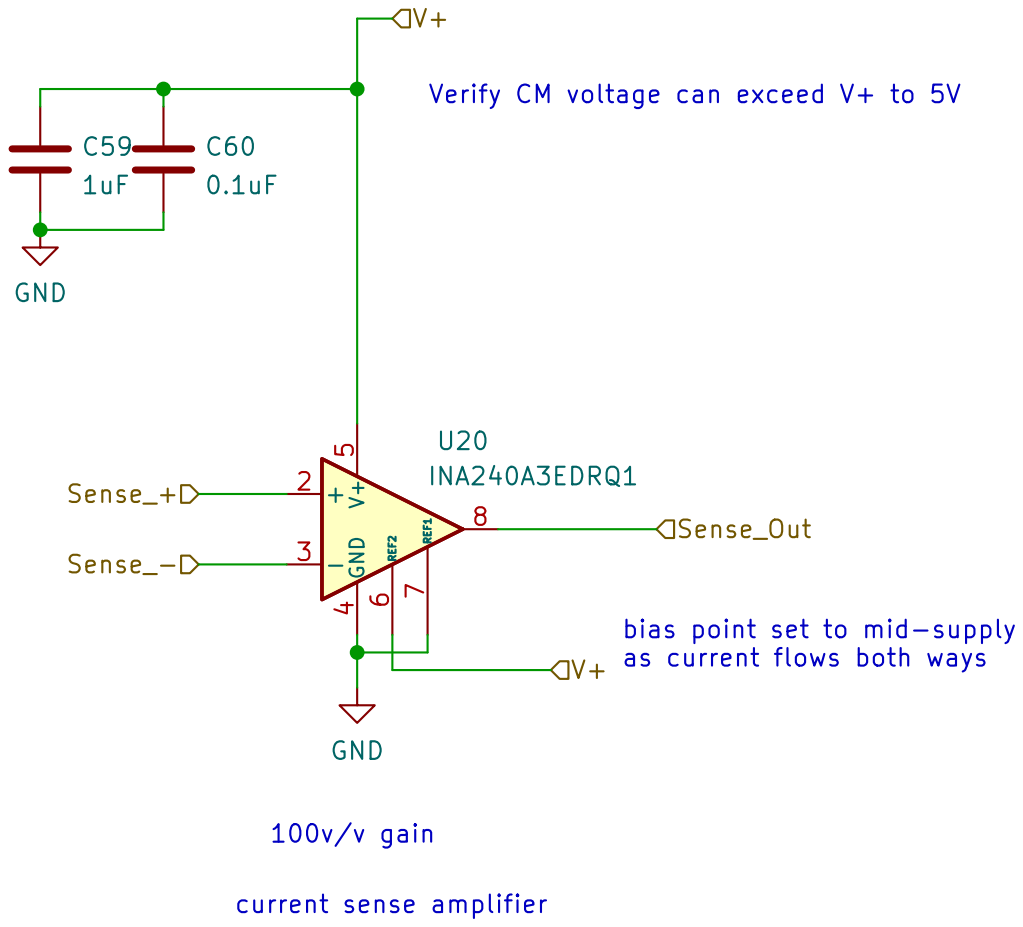
[picture p16: page 11]

bias point set to mid-supply
as current flows both ways

Sheet: /Magnetotorquer Drivers/Sense Amp 3/
File: Sense_Amp.kicad_sch
Id: 10/22 Title:

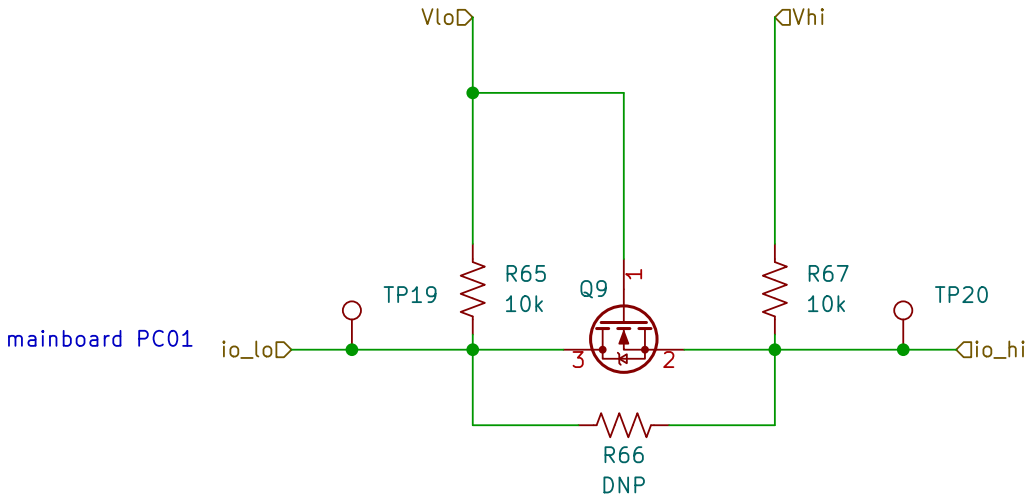
[picture p17: page 12]

File: Level_Shifter.kicad_sch Sheet: /Level Shifter 2/ R66 DNP

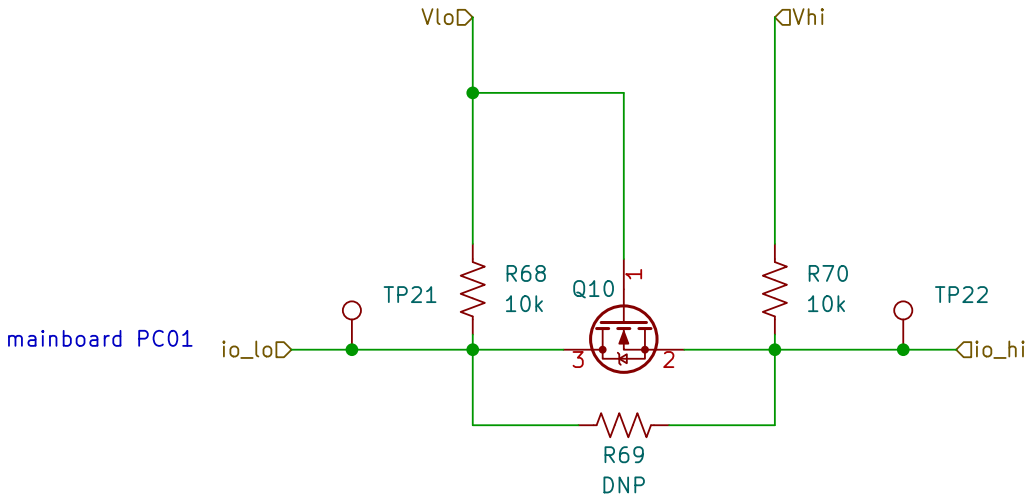
[picture p18: page 13]

File: Level_Shifter.kicad_sch Sheet: /Level Shifter 1/ R69 DNP

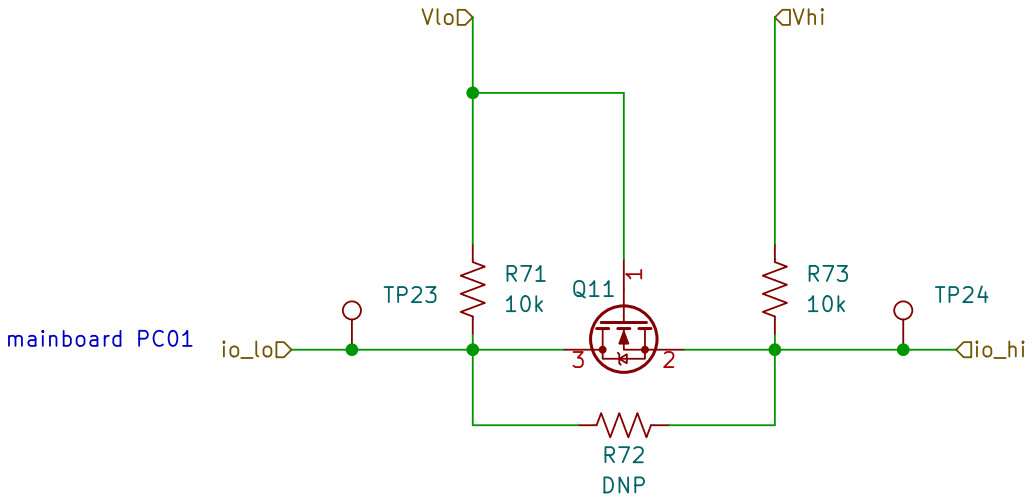
[picture p19: page 14]

File: Level_Shifter.kicad_sch Sheet: /Level Shifter 3/ R72 DNP

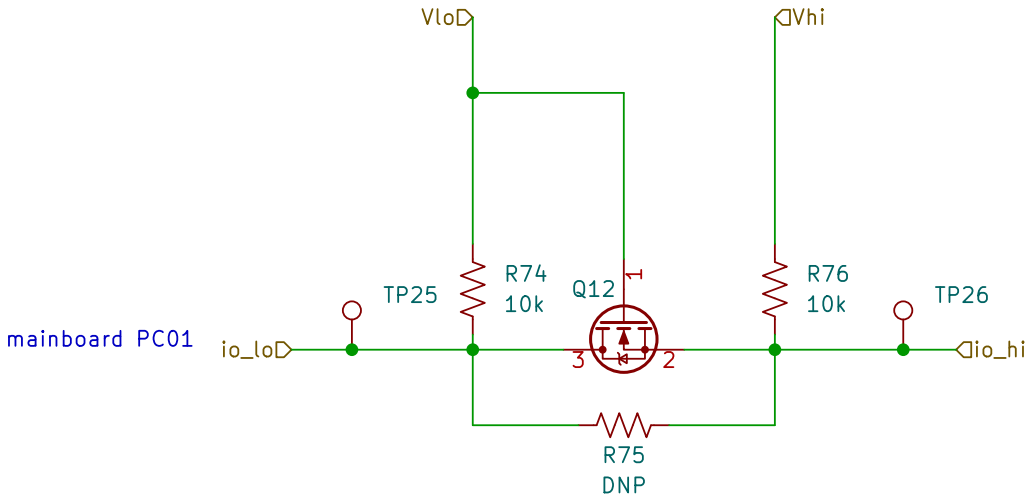
[picture p20: page 15]

File: Level_Shifter.kicad_sch Sheet: /Level Shifter 4/ R75 DNP

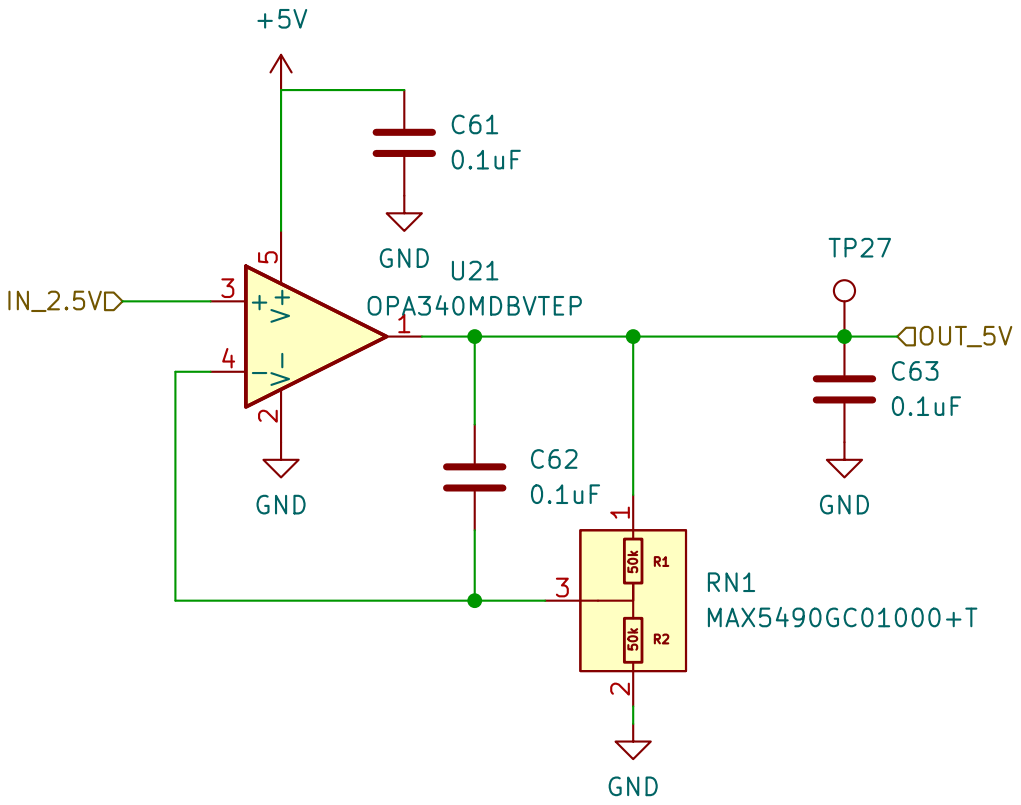
[picture p21: page 16]

Sheet: /Magnetotorquer Drivers/5V Amp 2/ GND

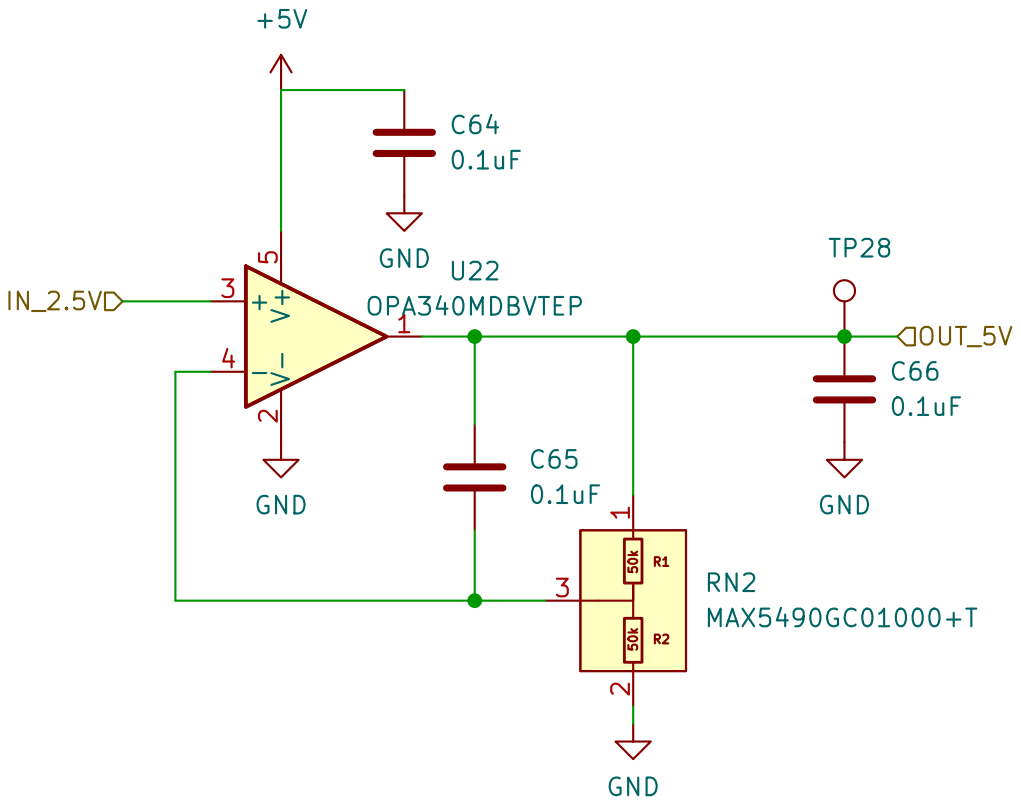
[picture p22: page 17]

Sheet: /Magnetotorquer Drivers/5V Amp 1/ GND

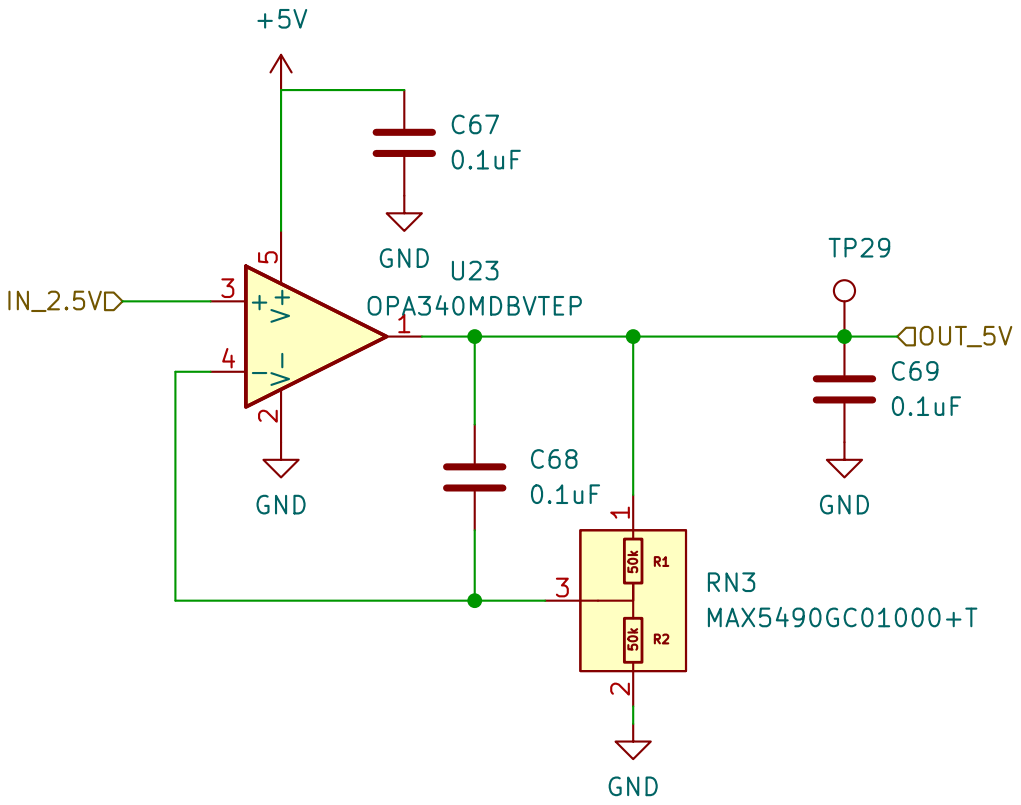
[picture p23: page 18]

Sheet: /Magnetotorquer Drivers/5V Amp 3/ GND

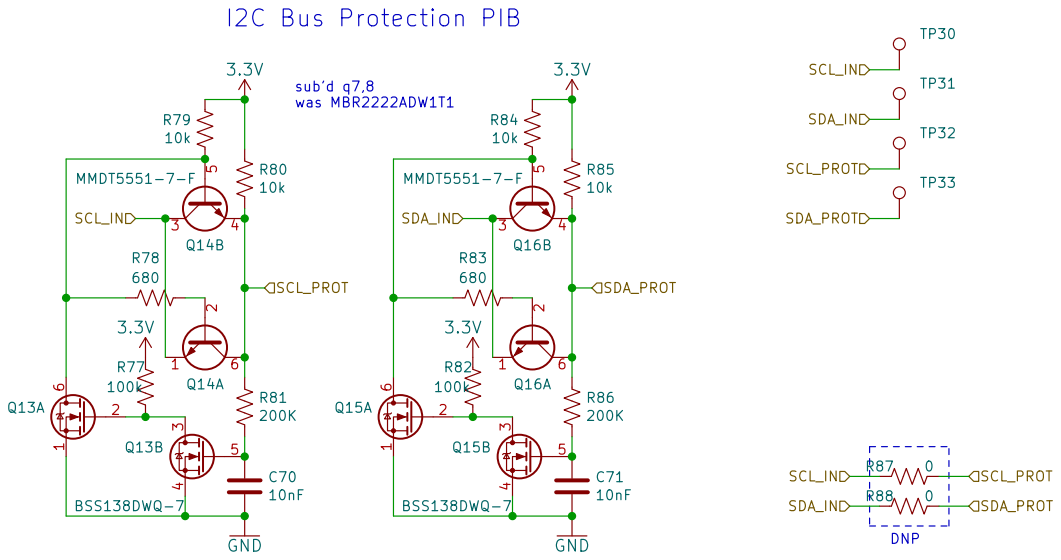
[picture p24: page 19]

File: I2C-Protection.kicad_sch Sheet: /I2C-Protection-1/
Id: 18/22 Title:

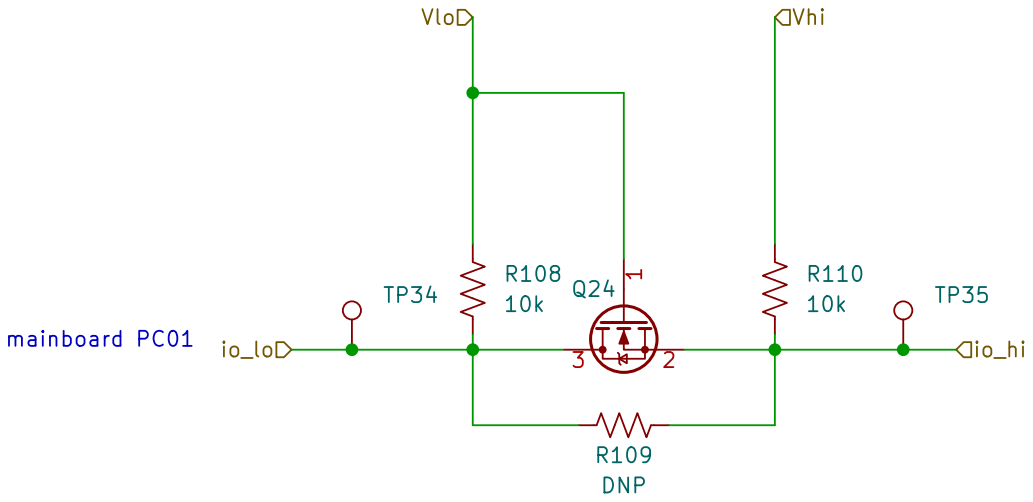
[picture p25: page 20]

File: Level_Shifter.kicad_sch Sheet: /Level Shifter 5/ R109 DNP

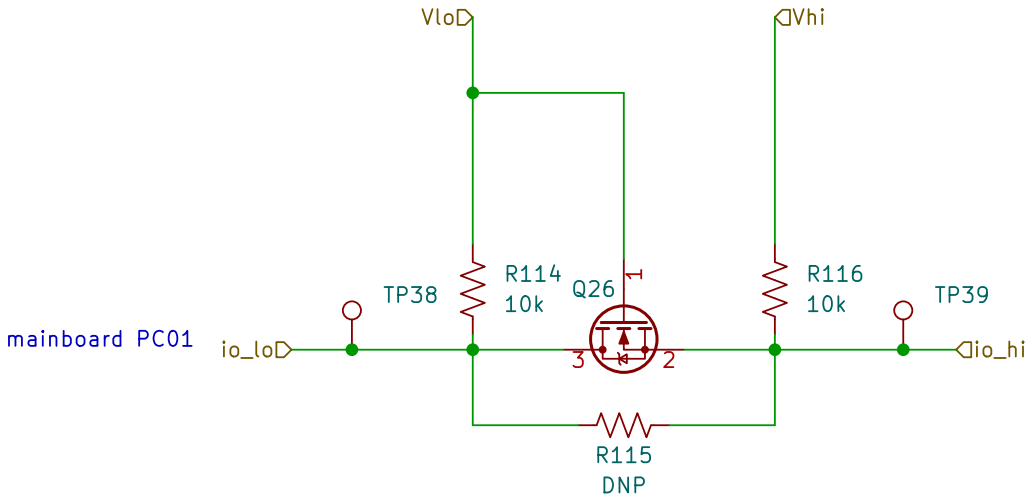
[picture p26: page 21]

File: Level_Shifter.kicad_sch Sheet: /Level Shifter 6/ R115 DNP

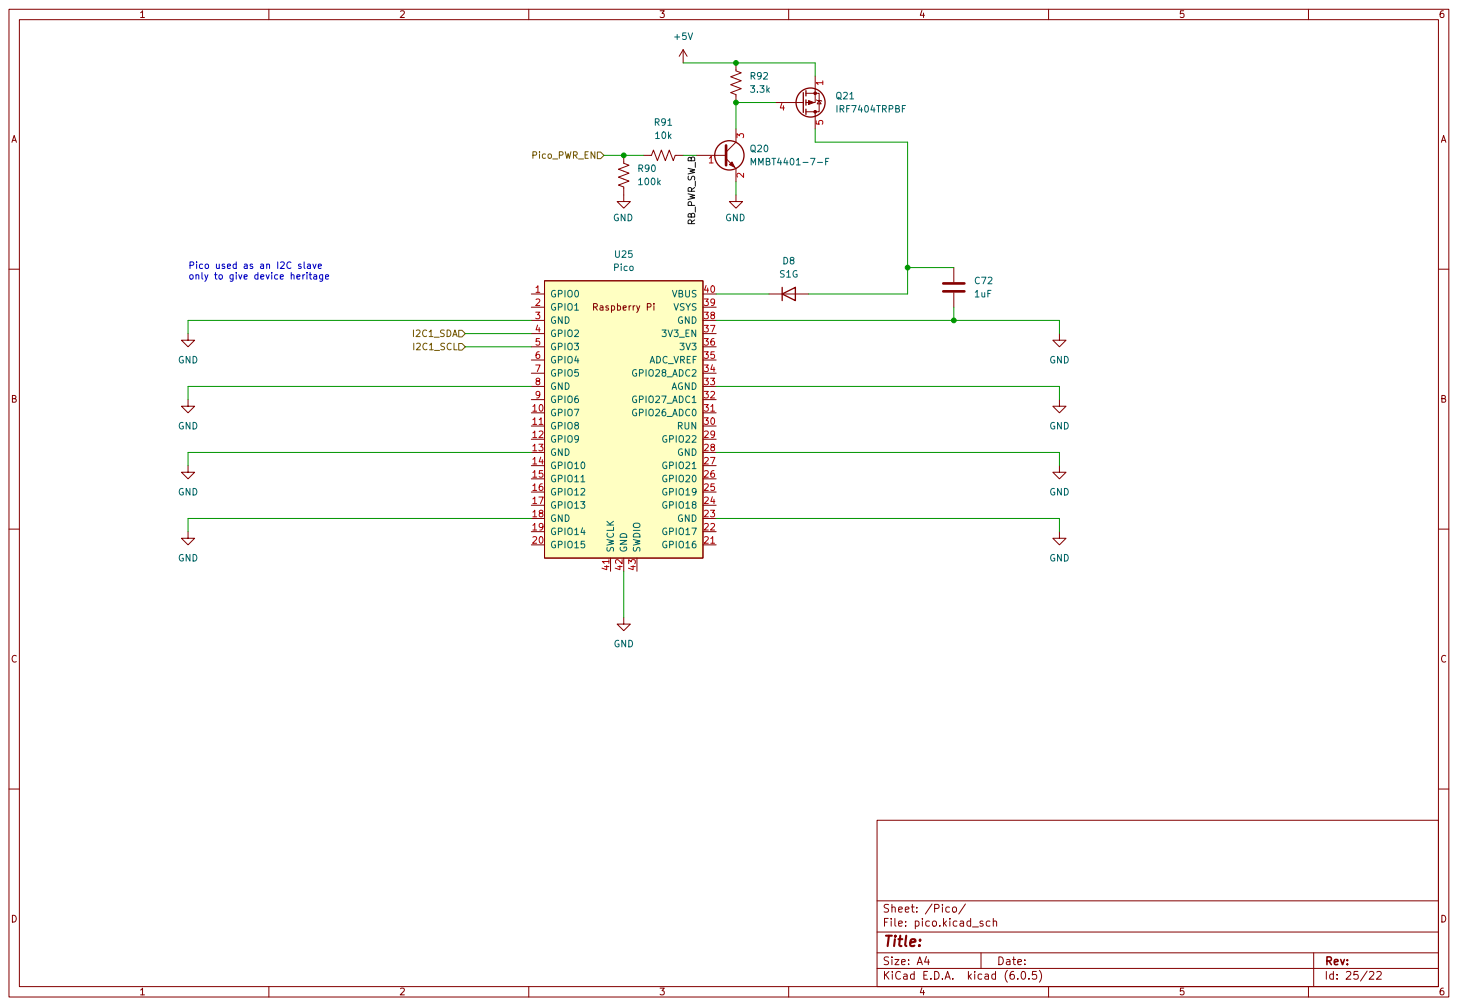
[picture p27: page 22]

Pico used as an I2C slave
only to give device heritage

File: pico.kicad_sch Sheet: /Pico/
