Sierra-Lobo/fp-pib-hw/revA1/design resources/Serial_Controlled_Motor_Driver_v20a.pdf

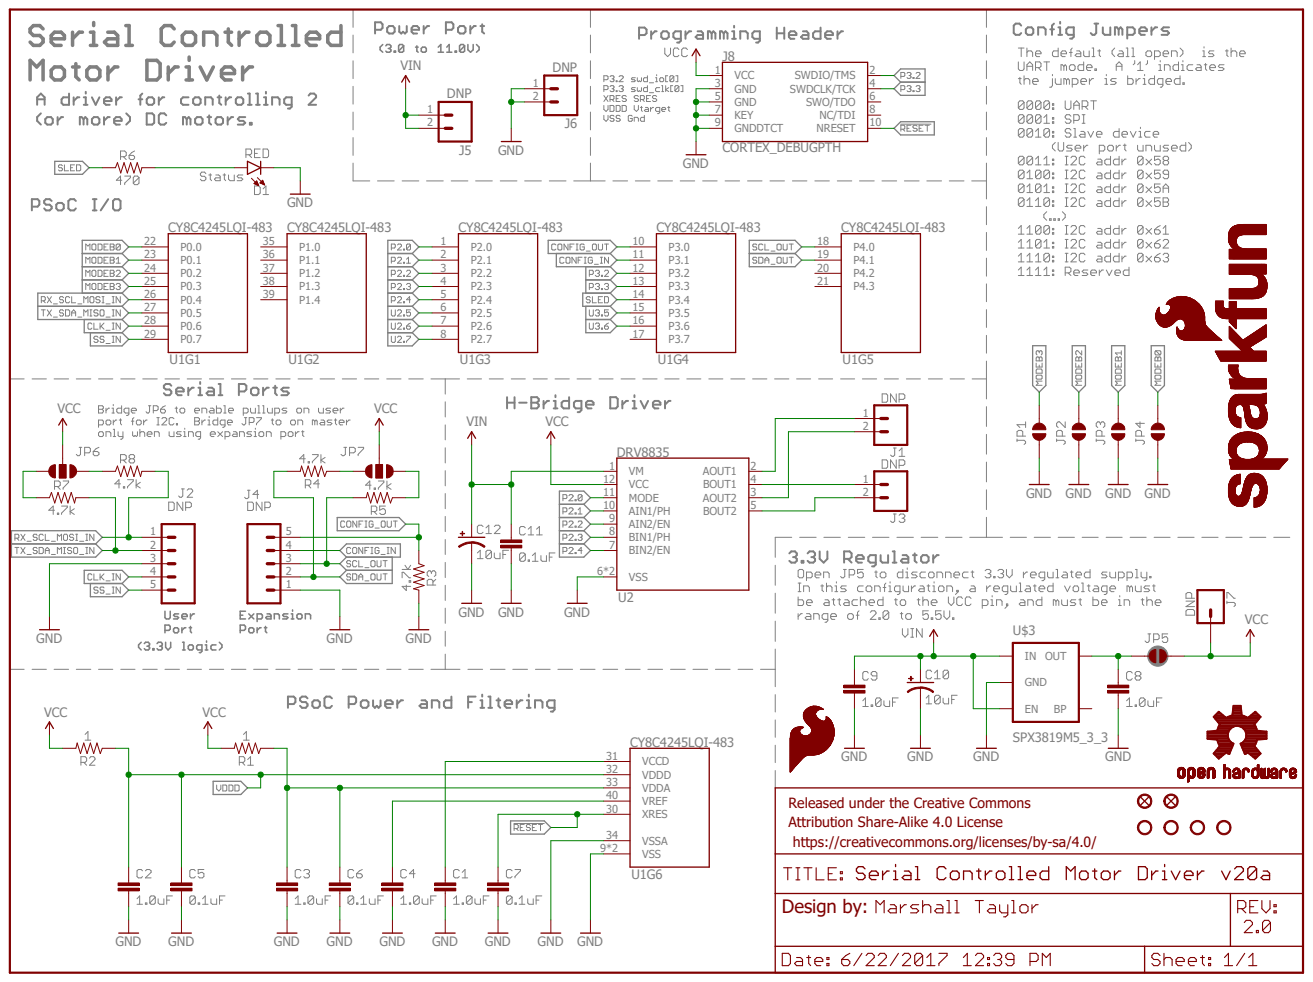
[picture p28: page 1]
CY8C4245LQI-483 CY8C4245LQI-483; CY8C4245LQI-483; GND; GND GND GND; VCC; DRV8835; VIN; SPX3819M5_3_3; DNP; CORTEX_DEBUGPTH; VCCD 31 VDDD 32 VDDA 33 VREF 40; VSSA 34 VSS 9*2; XRES 30; 1 VCC 12; AIN1/PH 10; AIN2/EN; VSS 6*2; MODE 11; BIN1/PH; BIN2/EN; AOUT1; AOUT2; 3 BOUT1; BOUT2; OUT; KEY; GNDDTCT; NRESET; 10 NC/TDI; 8 SWO/TDO; 6 SWDCLK/TCK; 4 SWDIO/TMS; Design by:

GND GND

Released under the Creative Commons
Attribution Share-Alike 4.0 License
https://creativecommons.org/licenses/by-sa/4.0/
