Sierra-Lobo/fp-pib-hw/revB/doc/master.pdf

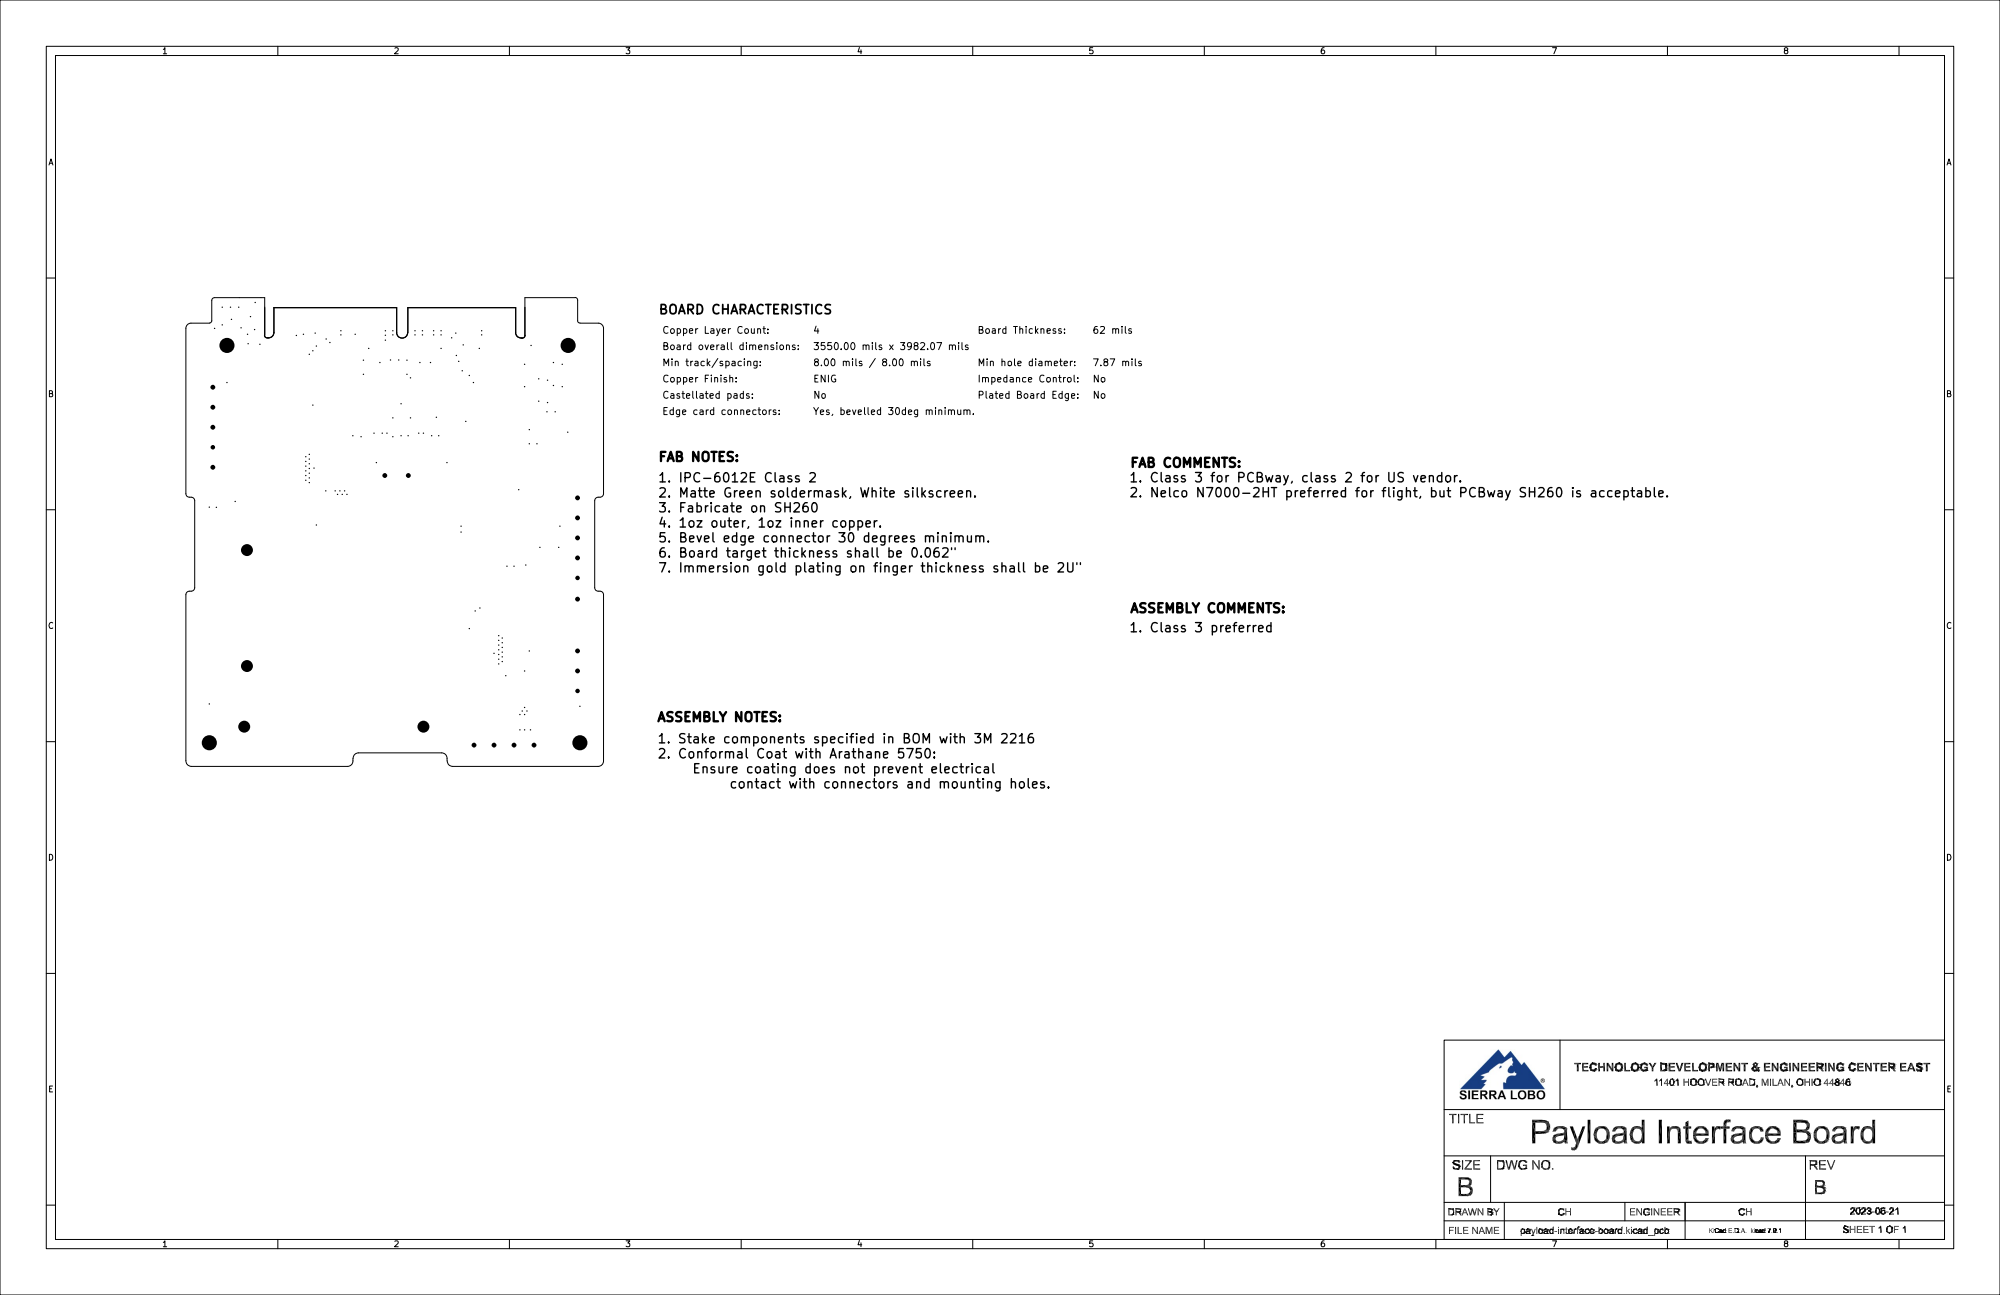
[picture p29: page 1]
