Sierra-Lobo/fp-pib-hw/revB/doc/pib-revB-asy.pdf

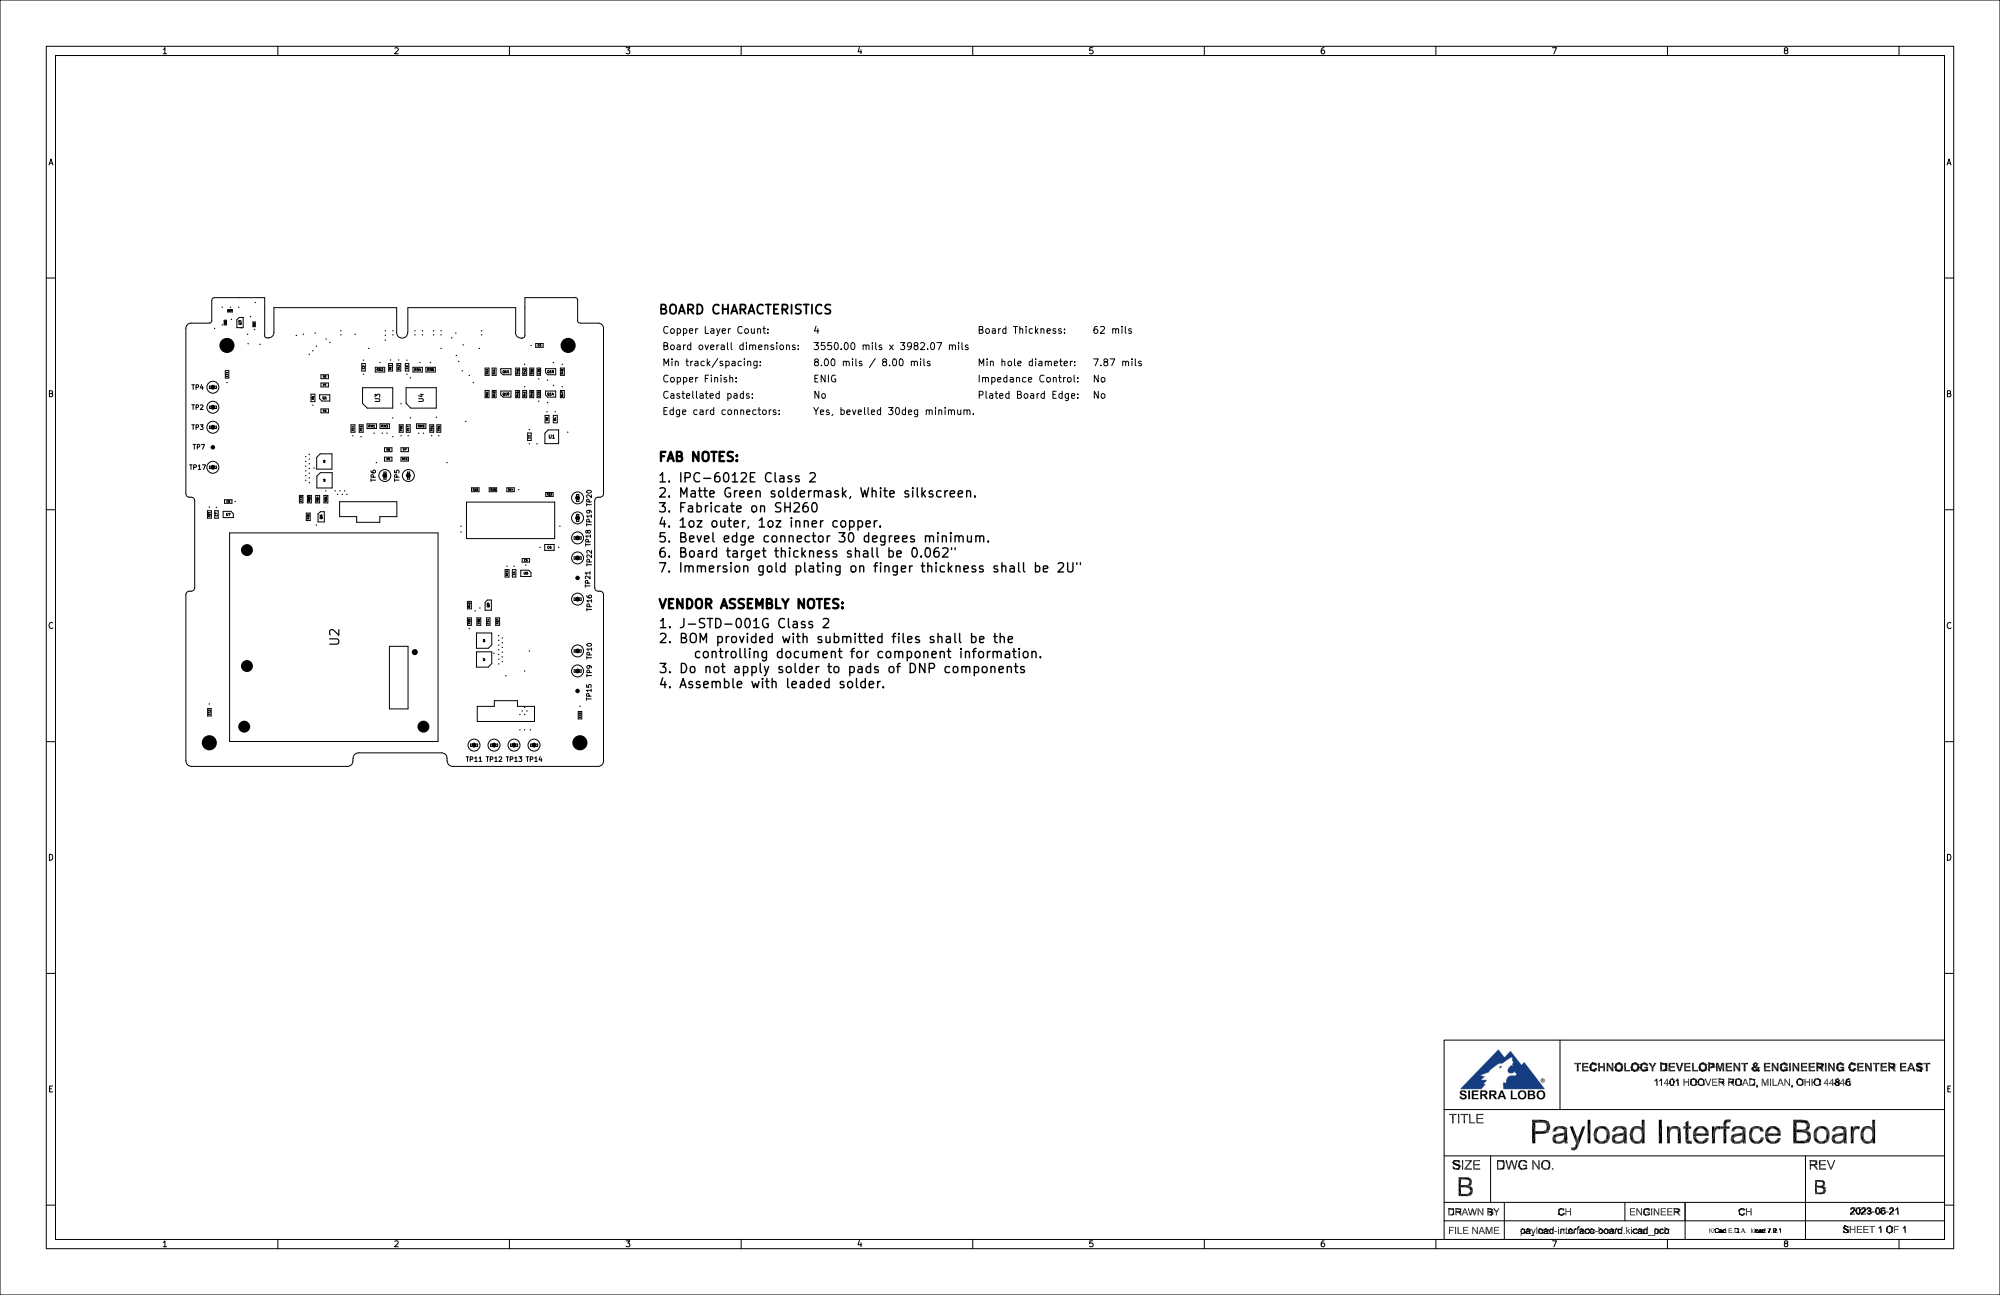
[picture p30: page 1]

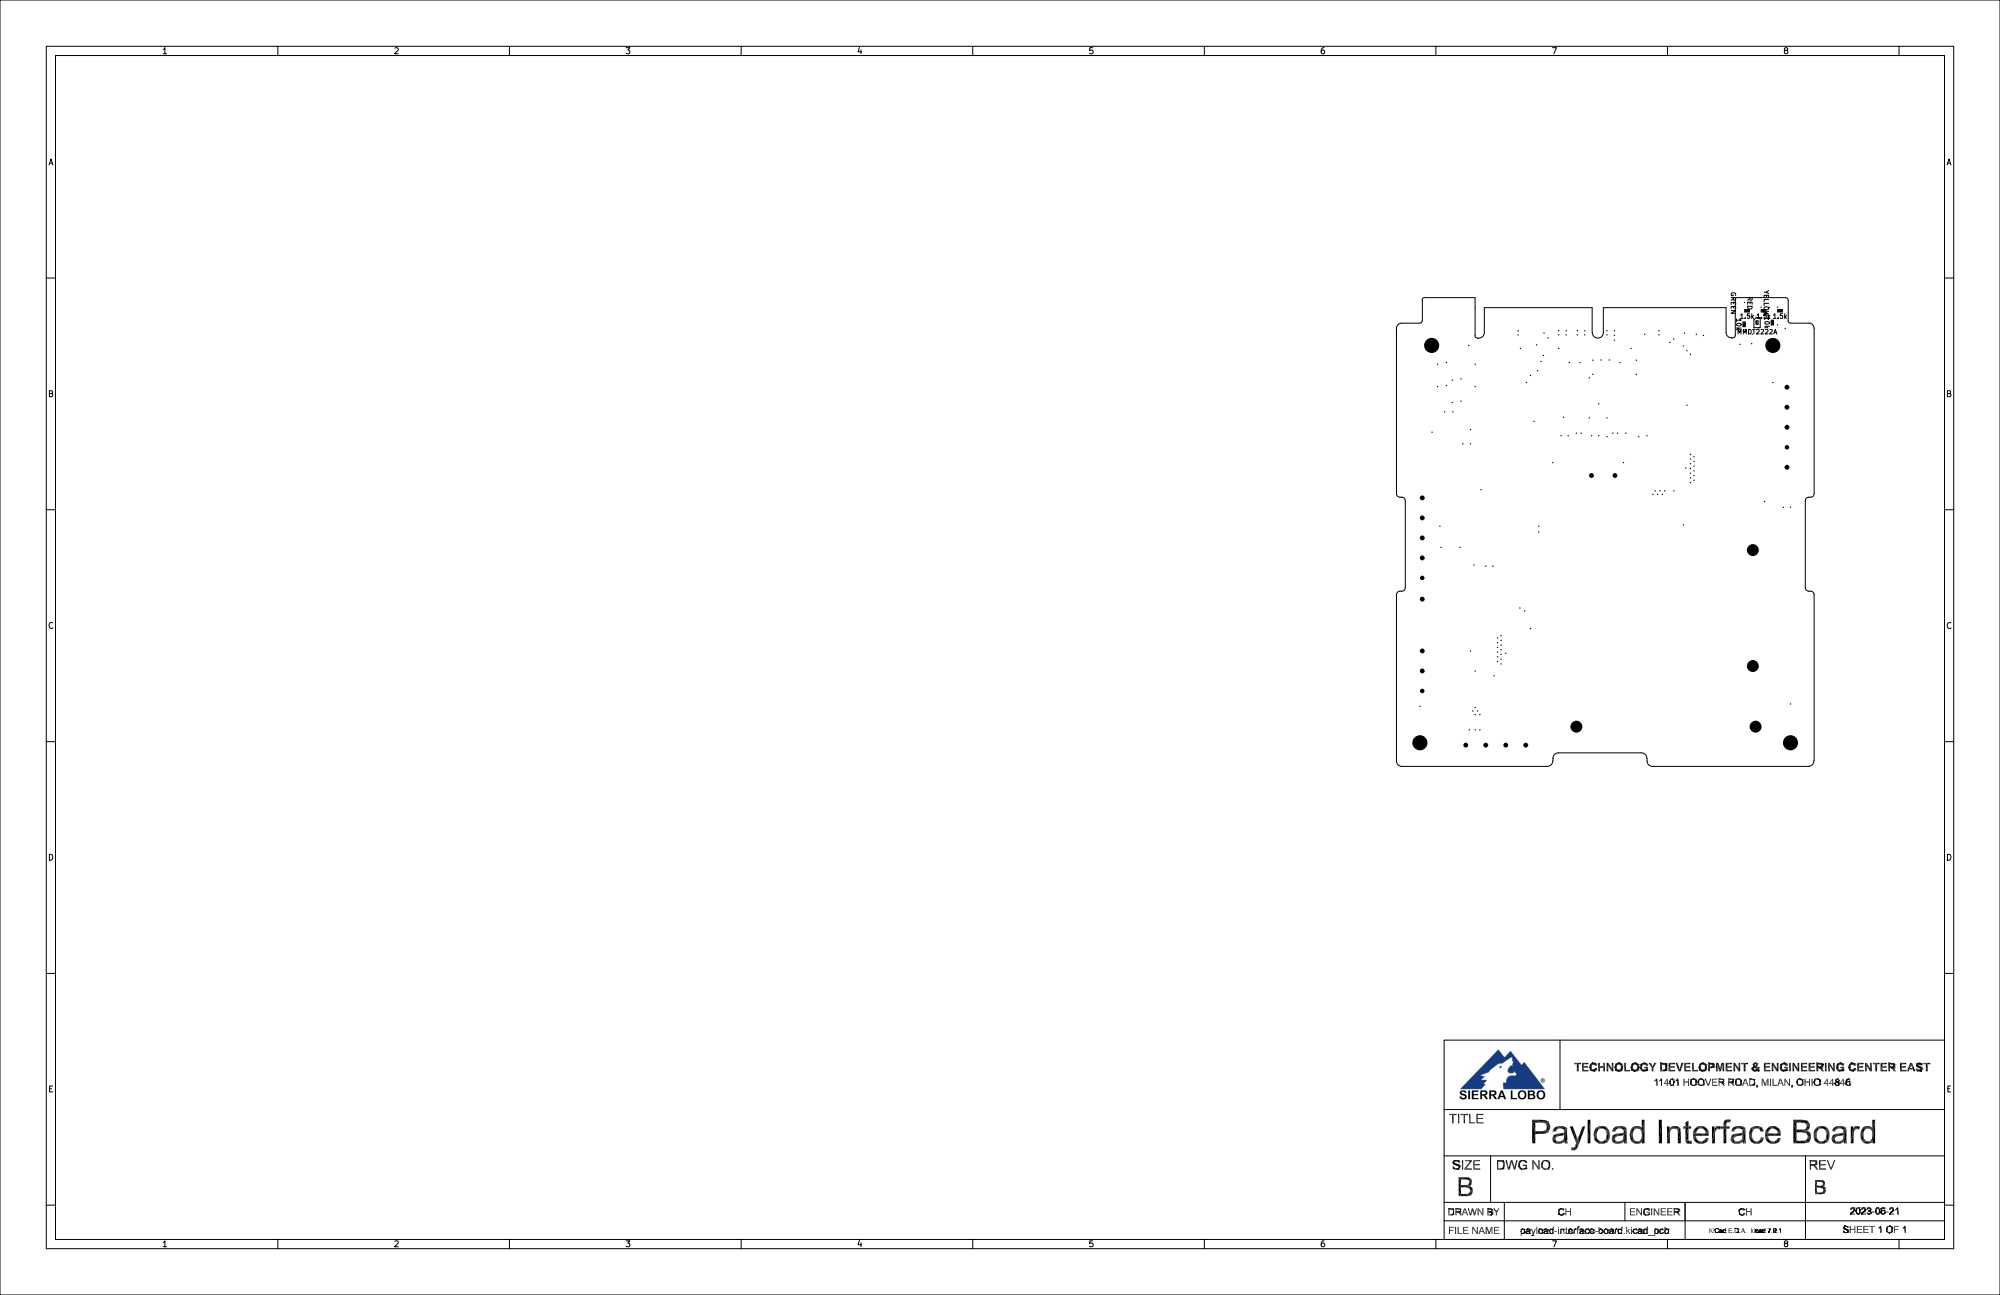
[picture p31: page 2]
