Sierra-Lobo/fp-pib-hw/(commit log)

2022-01-27 removed unnessasary
    [BLDC_Wheel_Driver.kicad_sch, BLDC_Wheel_Driver.sch, Blank-Card-Default.kicad_sch, Drivers.kicad_sch, Drivers.sch, FP Interface Card.kicad_sch, MCU.sch, OpenMV H7 Plus.kicad_sch]
2022-01-27 removed pre kicad v6 files
    [BLDC_Wheel_Driver.kicad_sch, Blank-Card-Default.sch, Drivers.kicad_sch, FP Interface Card.sch, OpenMV H7 Plus.kicad_sch]
2022-02-08 generated fab files
    [FP Interface Card-B_Cu.gbr, FP Interface Card-B_Mask.gbr, FP Interface Card-B_Paste.gbr, FP Interface Card-B_Silkscreen.gbr, FP Interface Card-Edge_Cuts.gbr, FP Interface Card-F_Cu.gbr, FP Interface Card-F_Mask.gbr, FP Interface Card-F_Paste.gbr]
2022-02-08 pib bom
    [FP Interface Card.csv, FP Interface Card.xlsx]
2022-02-09 bom updates
    [FP Interface Card.xlsx]
2022-02-21 majority of routing completed
    [5V_amp.kicad_sch, Blank-Card-Default.kicad_sch, FP Interface Card.kicad_pcb, FP Interface Card.kicad_sch, Full_Bridge.kicad_sch, I2C-Protection.kicad_sch, IMU.kicad_sch, Level_Shifter.kicad_sch]
2022-02-23 bom changes
2022-03-17 updated board
    [FP Interface Card.kicad_pcb]
2022-03-20 working on sch changes
    [FP Interface Card.kicad_sch, Full_Bridge.kicad_sch, I2C-Protection.kicad_sch, ball_deployer.kicad_sch, magnetotorquer-driver.kicad_sch]
2022-04-28 working on EM
    [FP Interface Card.kicad_sch, Full_Bridge.kicad_sch, magnetotorquer-driver.kicad_sch]
2022-05-12 design updates
    [5V_amp.kicad_sch, Blank-Card-Default.kicad_sch, FP Interface Card.kicad_pcb, FP Interface Card.kicad_sch, FP Interface Card.step, Full_Bridge.kicad_sch, I2C-Protection.kicad_sch, Level_Shifter.kicad_sch]
2022-05-13 friday changes
    [FP Interface Card.kicad_pcb, FP Interface Card.kicad_sch, Level_Shifter.kicad_sch, magnetotorquer-driver.kicad_sch, pico.kicad_sch]
2022-05-13 added current sensors and other design changes
    [FP Interface Card.kicad_sch, magnetotorquer-driver.kicad_sch]
2022-05-18 finished routing
    [FP Interface Card.kicad_pcb, FP Interface Card.kicad_sch, magnetotorquer-driver.kicad_sch]
2022-05-19 finished routing and silkscreen
    [FP Interface Card.kicad_sch]
2022-05-22 bom updated
    [FP Interface Card.xlsx]
2022-05-23 Update FP Interface Card.xlsx
    [FP Interface Card.xlsx]
2023-03-06 revB and repo reorganization branch
    [5V_amp.kicad_sch, Blank-Card-Default.kicad_sch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]
2023-03-14 working revB
    [5V_amp.kicad_sch, Blank-Card-Default.kicad_sch, FP Interface Card.kicad_sch, Full_Bridge.kicad_sch, I2C-Protection.kicad_sch, Level_Shifter.kicad_sch, Sense_Amp.kicad_sch, magnetotorquer-driver.kicad_sch]
2023-03-14 moving revB to correct folder
    [5V_amp.kicad_sch, Blank-Card-Default.kicad_sch, FP Interface Card.kicad_sch, Full_Bridge.kicad_sch, I2C-Protection.kicad_sch, Level_Shifter.kicad_sch, Sense_Amp.kicad_sch, magnetotorquer-driver.kicad_sch]
2023-03-14 removing old files
    [FP Interface Card.xlsx, FP Interface Card_old.xlsx]
2023-03-23 set resistor values for imu-stamp addressing
    [FP Interface Card.kicad_pcb, FP Interface Card.kicad_sch, IMU.kicad_sch, Level_Shifter.kicad_sch]
2023-03-23 updated bp pinout, added payload current sensor
    [FP Interface Card.kicad_pcb, FP Interface Card.kicad_sch, Sense_Amp.kicad_sch, magnetotorquer-driver.kicad_sch, payload-interface.kicad_sch]
2023-03-23 modified current sensor
    [FP Interface Card.kicad_pcb, FP Interface Card.kicad_sch, payload-interface.kicad_sch]
2023-03-23 fixed current sensor pwr
    [FP Interface Card.kicad_pcb, FP Interface Card.kicad_sch, payload-interface.kicad_sch]
2023-03-24 updated files
    [5V_amp.kicad_sch, ADM1176-1ARMZ-R7.STEP, Blank-Card-Default.kicad_sch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]
2023-06-21 revB initial commit
    [ADM1176-1ARMZ-R7.STEP, I2C-Protection.kicad_sch, RAVF164D_stp.stp, RockBLOCK_V_3B.STEP, T1M-06-F-SV-L.step, T1M-10-F-SV-L.step, imu-stamp.step, load_sw.kicad_sch]
2023-06-22 revB final
    [payload-interface-board-B_Cu.gbl, payload-interface-board-B_Mask.gbs, payload-interface-board-B_Silkscreen.gbo, payload-interface-board-Edge_Cuts.gm1, payload-interface-board-F_Cu.gtl, payload-interface-board-F_Mask.gts, payload-interface-board-F_Silkscreen.gto, payload-interface-board-NPTH-drl_map.gbr]
2023-07-05 updated BOM
    [I2C-Protection.kicad_sch, load_sw.kicad_sch, payload-interface-board.kicad_pcb, payload-interface-board.kicad_sch, pib-revB-bom.xlsx]
2023-08-16 added ibom
    [pib-revB-bom.xlsx]
